nabaztag2018/hardware/nfc_V1.0/Position of P1.jpg

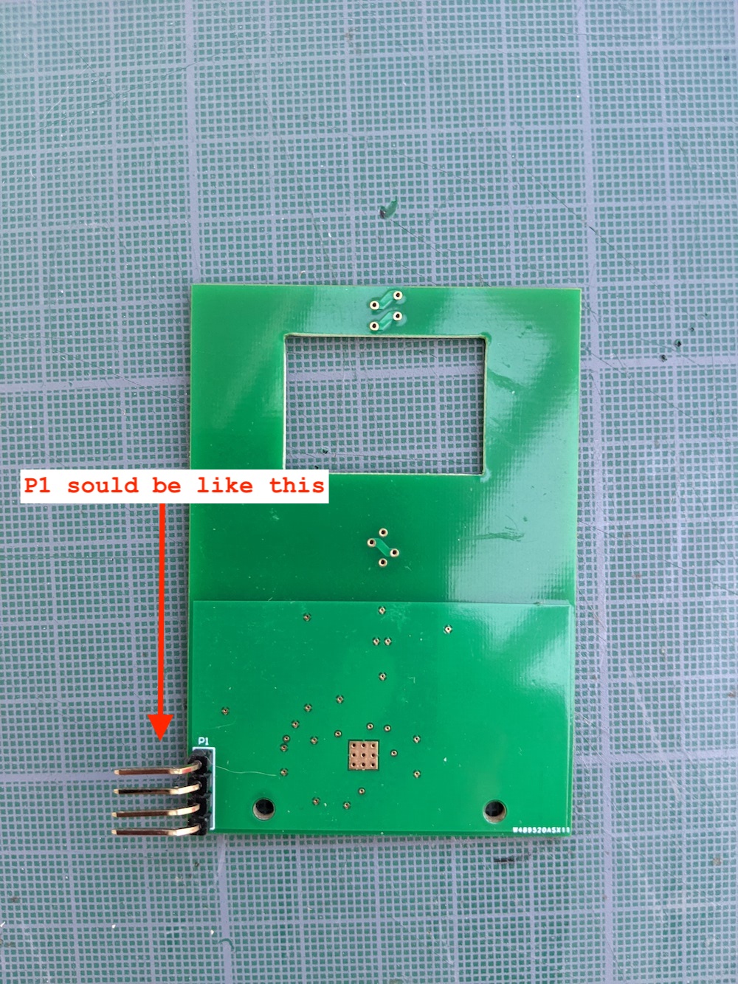
nfc_V1.0/Position of P1.jpg
