nabaztag2018/hardware/README.md

# Hardware

Tout ce qu'il faut pour refaire, modifier et surtout améliorer les cartes TagTagTag et NFC
