nabaztag2018/hardware/tagtagtag_V2.0/Nabaztag_RPI_V2.0_BOM.xlsx

Comment | Value | Quantity | Description | Designator | Unit price (octopart) | Package / Boitier | Voltage | Supplier link (octopart) | Supplier Link
CAPACITOR
0.1uF | 0.1uF | 26 | Non-polarised capacitor | C1, C2, C3, C4, C6, C8, C12, C15, C16, C17, C18, C20, C25, C27, C29, C31, C35, C36, C42, C46, C48, C49, C50, C52, C54, C62 | 0.088 | 0603 (1608 métrique) | 25V | 710-885012206071 (https://octopart.com/click/track?country=FR&ct=offers&ppid=53914780&sid=2401&sig=05a9095&vpid=254313904) | https://www.mouser.fr/ProductDetail/Wurth-Electronics/885012206071
10uF | 10uF | 13 | Non-polarised capacitor | C5, C10, C14, C24, C26, C30, C32, C37, C41, C45, C47, C51, C53 | 0.167 | 0603 (1608 métrique) | 10V | 81-GRM188R61A106KE9J (https://octopart.com/click/track?country=FR&ct=offers&ppid=57367330&sid=2401&sig=0bbd334&vpid=260629774) | https://eu.mouser.com/ProductDetail/Murata-Electronics/GRM188R61A106KE69J
1uF | 1uF | 6 | Non-polarised capacitor | C7, C11, C21, C28, C59, C61 | 0.14 | 0603 (1608 métrique) | 6,3V | 732-7900-1-ND (https://octopart.com/click/track?country=FR&ct=offers&ppid=53914708&sid=459&sig=0998f88&vpid=229678700) | https://www.digikey.fr/product-detail/fr/885012106003/732-7900-1-ND/5454527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
100uF | 100uF | 1 | polarised cap | C9 | 0.573 | Radial, boîtier métallique - CMS | 16V | PCE3750CT-ND (https://www.digikey.fr/product-detail/fr/panasonic-electronic-components/EEE-HC1C101XP/PCE3750CT-ND/672804) | https://www.digikey.fr/product-detail/fr/panasonic-electronic-components/EEE-HC1C101XP/PCE3750CT-ND/672804
1000uF | 1000uF | 1 | polarised cap | C13 | 0.27 | Radial, boîtier métallique - CMS | 6,3V | 2611416 (https://fr.farnell.com/multicomp/mcvvt6r3m102fb3l/condensateur-1000-f-6-3v-cms/dp/2611416?st=MCVVT6R3M102) | https://fr.farnell.com/multicomp/mcvvt6r3m102fb3l/condensateur-1000-f-6-3v-cms/dp/2611416?st=MCVVT6R3M102
220uF | 220uF | 1 | polarised cap | C19 | 0.439 | Radial, boîtier métallique - CMS | 16V | 1823839 (https://fr.farnell.com/nichicon/uwt1c221mcl1gs/aluminum-electrolytic-capacitor/dp/1823839?st=UWT1C221MCL1GS) | https://fr.farnell.com/nichicon/uwt1c221mcl1gs/aluminum-electrolytic-capacitor/dp/1823839?st=UWT1C221MCL1GS
100pF | 100pF | 2 | Non-polarised capacitor | C22, C60 | 0.11 | 0603 (1608 métrique) | 50V | 1710167 (https://fr.farnell.com/multicomp/mc0603n101k500ct/ceramic-capacitor-100pf-50v-c0g/dp/1710167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) | https://fr.farnell.com/multicomp/mc0603n101k500ct/ceramic-capacitor-100pf-50v-c0g/dp/1710167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
1nF | 1nF | 1 | Non-polarised capacitor | C23 | 0.1 | 0603 (1608 métrique) | 16V | 2904797 (https://fr.farnell.com/kemet/c0603s102k4racauto/cond-mlcc-aec-q200-1000pf-16v/dp/2904797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) | https://fr.farnell.com/kemet/c0603s102k4racauto/cond-mlcc-aec-q200-1000pf-16v/dp/2904797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
33pF | 33pF | 4 | Non-polarised capacitor | C43, C44, C55, C56 | 0.15 | 0603 (1608 métrique) | 50V | 1710223 (https://fr.farnell.com/multicomp/mc0603n330k500ct/ceramic-capacitor-33pf-50v-c0g/dp/1710223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) | https://fr.farnell.com/multicomp/mc0603n330k500ct/ceramic-capacitor-33pf-50v-c0g/dp/1710223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
4.7uF | 4.7uF | 2 | Non-polarised capacitor | C57, C58 | 0.09 | 0603 (1608 métrique) | 6,3V | 1276-1907-1-ND (https://www.digikey.fr/product-detail/fr/samsung-electro-mechanics/CL10A475MQ8NNNC/1276-1907-1-ND/3889993) | https://www.digikey.fr/product-detail/fr/samsung-electro-mechanics/CL10A475MQ8NNNC/1276-1907-1-ND/3889993
22uF | 22uF | 2 | Non-polarised capacitor | C38, C39 | 0.441 | 0603 (1608 métrique) | 6,3V | 810-C1608X5R0J226M (https://octopart.com/click/track?country=FR&ct=offers&ppid=26013464&sid=2401&sig=05a7d84&vpid=66164155) | https://www.mouser.fr/ProductDetail/TDK/C1608X5R0J226M080AC
470nF | 470nF | 2 | Non-polarised capacitor | C63, C64 | 0.2 | 0603 (1608 métrique) | 16V | 490-3295-1-ND (https://octopart.com/click/track?country=FR&ct=offers&ppid=196914&sid=459&sig=000aa69&vpid=1208009) | https://www.digikey.fr/product-detail/fr/GRM188R71C474KA88D/490-3295-1-ND/702836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
75pF | 75pF | 1 | Non-polarised capacitor | C40 | 0.273 | 0603 (1608 métrique) | 50v | 80-C0603C750J5G (https://octopart.com/click/track?country=FR&ct=offers&ppid=9138607&sid=2401&sig=06368cf&vpid=37752048) | https://www.mouser.fr/ProductDetail/KEMET/C0603C750J5GACTU
DIODES
Diode 1N4001 |  | 1 | Diode | D1 | 0.1 | DO-204AL, DO-41, axial |  | 641-1310-1-ND (https://octopart.com/click/track?country=FR&ct=offers&ppid=19043185&sid=459&sig=0e15afc&vpid=34052689) | https://www.digikey.fr/product-detail/fr/1N4001-G/641-1310-1-ND/1979675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
Diode_Transil_SM6T |  | 1 | Diode | D2 | 0.405 | DO-214AA-2 (SMB) |  | 511-SM6T12CA (https://octopart.com/click/track?country=FR&ct=offers&ppid=349709&sid=2401&sig=0472e83&vpid=40871267) | https://www.mouser.fr/ProductDetail/STMicroelectronics/SM6T12CA
Diode_Shottky_VS-20BQ030HM3 |  | 1 | Diode | D3 | 0.44 | DO-214AA, SMB |  | VS-20BQ030HM3/5BTGI-ND (https://octopart.com/click/track?country=FR&ct=offers&ppid=65895459&sid=459&sig=0223a70&vpid=448911440) | https://www.digikey.fr/product-detail/fr/VS-20BQ030HM3-5BT/VS-20BQ030HM3-5BTGI-ND/5134969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
Diode Toshiba DF2S6.8FS,L3M |  | 1 | Diode | D4 | 0.16 | SOD-923 |  | DF2S6.8FS(TL4D)CT-ND (https://www.digikey.fr/product-detail/fr/toshiba-semiconductor-and-storage/DF2S6.8FSL3M/DF2S6.8FS-TL4D-CT-ND/3191336) | https://www.digikey.fr/product-detail/fr/toshiba-semiconductor-and-storage/DF2S6.8FSL3M/DF2S6.8FS-TL4D-CT-ND/3191336
INDUCTOR
33ohm | 33ohm | 2 | Inductor 0603 BLM18PG330SN | L1, L2 | 0.09 | 0603 (1608 métrique) |  | 490-5220-1-ND (https://octopart.com/click/track?country=FR&ct=offers&ppid=755255&sid=459&sig=0d2c2fc&vpid=34232814) | https://www.digikey.fr/product-detail/fr/BLM18PG330SN1D/490-5220-1-ND/1948396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
Murata_1264EY-150M=P3 | 15uH | 1 | Inductor 15uH | L3 | 0.56 | 2424 (6060) |  | 2871570RL (https://fr.farnell.com/murata/1264ey-150m-p3/inductance-15uh-2-1a-20-bobinee/dp/2871570RL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) | https://fr.farnell.com/murata/1264ey-150m-p3/inductance-15uh-2-1a-20-bobinee/dp/2871570RL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
100ohm | 100ohm | 1 | Inductor MPZ1608D101BTA00 | L4 | 0.09 | 0603 (1608 métrique) |  | 445-2988-1-ND (https://www.digikey.fr/product-detail/fr/tdk-corporation/MPZ1608D101BTA00/445-2988-1-ND/1084531) | https://www.digikey.fr/product-detail/fr/tdk-corporation/MPZ1608D101BTA00/445-2988-1-ND/1084531
2.5kohm | 2.5kohm | 2 | Inductor BLM18BD252SN1D | L5, L6 | 0.723 | 0603 (1608 métrique) |  | 490-1028-1-ND (https://www.digikey.fr/product-detail/fr/murata-electronics-north-america/BLM18BD252SN1D/490-1028-1-ND/584476) | https://www.digikey.fr/product-detail/fr/murata-electronics-north-america/BLM18BD252SN1D/490-1028-1-ND/584476
100nH | 100nH | 2 | Inductor MLZ1608DR10DT | L7, L8 | 0.138 | 0603 (1608 métrique) |  | 2215630 (https://fr.farnell.com/tdk/mlz1608dr10dt/inductance-0-1uh-5-blindee/dp/2215630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) | https://fr.farnell.com/tdk/mlz1608dr10dt/inductance-0-1uh-5-blindee/dp/2215630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
RESISTOR
470ohm | 470 ohm | 2 | Resistor | R1, R3 | 0.088 | 0603 (1608 métrique) |  | 2908375 (https://fr.farnell.com/bourns/cr0603-jw-471elf/resis-couche-epaisse-470r-0-1w/dp/2908375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) | https://fr.farnell.com/bourns/cr0603-jw-471elf/resis-couche-epaisse-470r-0-1w/dp/2908375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
10kohm | 10 kohm | 11 | Resistor | R2, R4, R5, R6, R8, R9, R13, R14, R15, R19, R37 | 0.09 | 0603 (1608 métrique) |  | 1632392 (https://fr.farnell.com/multicomp/mc0603saf1002t5e/res-thick-film-10k-1-0-1w-0603/dp/1632392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) | https://fr.farnell.com/multicomp/mc0603saf1002t5e/res-thick-film-10k-1-0-1w-0603/dp/1632392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
20kohm | 20 kohm | 1 | Resistor | R7 | 0.088 | 0603 (1608 métrique) |  | RHM20KDCT-ND (https://octopart.com/click/track?country=FR&ct=offers&ppid=29236154&sid=459&sig=0eb9ce1&vpid=76920462) | https://www.digikey.fr/product-detail/fr/ESR03EZPJ203/RHM20KDCT-ND/4053745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
120ohm | 120 ohm | 2 | Resistor | R11, R12 | 0.09 | 0603 (1608 métrique) |  | 1652832 (https://fr.farnell.com/vishay/crcw0603120rfkea/res-couche-epaisse-120r-1-0-1w/dp/1652832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) | https://fr.farnell.com/vishay/crcw0603120rfkea/res-couche-epaisse-120r-1-0-1w/dp/1652832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
1kohm | 1 kohm | 3 | Resistor | R18, R34, R35 | 0.14 | 0603 (1608 métrique) |  | 2335830 (https://fr.farnell.com/panasonic/erjpa3f1001v/res-couche-epaisse-1k-1-0-25w/dp/2335830?CMP=GRHB-OCTOPART) | https://fr.farnell.com/panasonic/erjpa3f1001v/res-couche-epaisse-1k-1-0-25w/dp/2335830?CMP=GRHB-OCTOPART
10ohm | 10 ohm | 5 | Resistor | R20, R21, R22, R31, R32 | 0.09 | 0603 (1608 métrique) |  | P10.00BYCT-ND (https://octopart.com/click/track?country=FR&ct=offers&ppid=51302195&sid=459&sig=0e775f9&vpid=175672005) | https://www.digikey.fr/product-detail/fr/ERJ-PA3F10R0V/P10.00BYCT-ND/5036118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
4.7kohm | 4.7 kohm | 4 | Resistor | R10, R16, R23, R24 | 0.09 | 0603 (1608 métrique) |  | P4.7KGCT-ND (https://octopart.com/click/track?country=FR&ct=offers&ppid=55422110&sid=459&sig=073857f&vpid=188062302) | https://www.digikey.fr/product-detail/fr/ERJ-3GEYJ472V/P4.7KGCT-ND/135199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
510kohm | 510 kohm | 1 | Resistor | R27 | 0.09 | 0603 (1608 métrique) |  | P510KHCT-ND (https://octopart.com/click/track?country=FR&ct=offers&ppid=55403664&sid=459&sig=0ed8e5a&vpid=188061721) | https://www.digikey.fr/product-detail/fr/ERJ-3EKF5103V/P510KHCT-ND/1746789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
49.9ohm | 49.9 ohm | 1 | Resistor | R28 | 0.09 | 0603 (1608 métrique) |  | P49.9HCT-ND (https://octopart.com/click/track?country=FR&ct=offers&ppid=55421799&sid=459&sig=04574ae&vpid=188061714) | https://www.digikey.fr/product-detail/fr/ERJ-3EKF49R9V/P49.9HCT-ND/198412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
100kohm | 100 kohm | 2 | Resistor | R17, R29 | 0.09 | 0603 (1608 métrique) |  | 1646028 (https://fr.farnell.com/multicomp/mc0603saf1003t5e/res-thick-film-100k-1-0-1w-0603/dp/1646028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) | https://fr.farnell.com/multicomp/mc0603saf1003t5e/res-thick-film-100k-1-0-1w-0603/dp/1646028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
13.3kohm | 13.3 kohm | 1 | Resistor | R30 | 0.09 | 0603 (1608 métrique) |  | P13.3KHCT-ND (https://octopart.com/click/track?country=FR&ct=offers&ppid=55421458&sid=459&sig=0123c35&vpid=188060510) | https://www.digikey.fr/product-detail/fr/ERJ-3EKF1332V/P13.3KHCT-ND/198150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
15kohm | 15 kohm | 1 | Resistor | R38 | 0.09 | 0603 (1608 métrique) |  | P15KGCT-ND (https://octopart.com/click/track?country=FR&ct=offers&ppid=55397035&sid=459&sig=0191300&vpid=188062134) | https://www.digikey.fr/product-detail/fr/ERJ-3GEYJ153V/P15KGCT-ND/62708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
30.1kohm | 30.1 kohm | 2 | Resistor | R25, R26 | 0.09 | 0603 (1608 métrique) |  | P30.1KHCT-ND (https://octopart.com/click/track?country=FR&ct=offers&ppid=55421673&sid=459&sig=05b57b3&vpid=188061214) | https://www.digikey.fr/product-detail/fr/ERJ-3EKF3012V/P30.1KHCT-ND/198319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
100ohm | 100 ohm | 2 | Resistor | R33, R36 | 0.09 | 0603 (1608 métrique) |  | P100GCT-ND (https://www.digikey.fr/product-detail/fr/panasonic-electronic-components/ERJ-3GEYJ101V/P100GCT-ND/134714) | https://www.digikey.fr/product-detail/fr/panasonic-electronic-components/ERJ-3GEYJ101V/P100GCT-ND/134714
LEDs
Neopixel_3535 |  | 5 |  | U1, U2, U3, U4, U10 | 0.429 | SK6812 (3535) |  | 1528-1542-ND (https://octopart.com/click/track?country=FR&ct=offers&ppid=68087194&sid=459&sig=01d4183&vpid=244416654) | https://www.digikey.fr/product-detail/fr/2659/1528-1542-ND/5804108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
ICs
CMM-3729AT-42316-TR |  | 2 | Mems microphone | MIC1, MIC2 | 1.28 | 3.76 MM X 2.24 MM |  | 102-5078-1-ND (https://www.digikey.fr/product-detail/fr/CMM-3729AT-42316-TR/102-5078-1-ND/9748846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) | https://www.digikey.fr/product-detail/fr/CMM-3729AT-42316-TR/102-5078-1-ND/9748846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
SN754410NE |  | 1 | Quadruple Half-H Driver | U5 | 2.1 | DIP 16 |  | 1470411 (https://octopart.com/click/track?country=FR&ct=offers&ppid=1320&sid=819&sig=0953c5b&vpid=548228289) | https://fr.farnell.com/texas-instruments/sn754410ne/ic-peripheral-driver-half-h-1a/dp/1470411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
LM1117MPX-3.3/NOPB |  | 1 | 800mA Low-Dropout Linear Regulator, 4-pin SOT-223, Pb-Free | U6 | 0.969 | SOT-223-4 |  | 926-LM1117MPX3.3NOPB (https://octopart.com/click/track?country=FR&ct=offers&ppid=22615741&sid=2401&sig=030e488&vpid=57203299) | https://www.mouser.fr/ProductDetail/Texas-Instruments/LM1117MPX-33-NOPB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
LM393D |  | 1 | Dual Differential Comparator | U7 | 0.36 | 8-SOIC |  | 296-1015-5-ND (https://octopart.com/click/track?country=FR&ct=offers&ppid=55400836&sid=459&sig=0240896&vpid=188084280) | https://www.digikey.fr/product-detail/fr/LM393D/296-1015-5-ND/277044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
SN74LVC2G17DBVR |  | 1 | Dual schmitt trigger buffer | U8 | 0.467 | SOT-23-6 |  | 595-SN74LVC2G17DBVR (https://octopart.com/click/track?country=FR&ct=offers&ppid=422947&sid=2401&sig=0809b4c&vpid=37654799) | https://www.mouser.fr/ProductDetail/595-SN74LVC2G17DBVR
BSS138 |  | 2 | N channel MOSFET | U9, U11 | 0.38 | SOT-23-3 |  | BSS138NH6327XTSA2CT-ND (https://octopart.com/click/track?country=FR&ct=offers&ppid=21522140&sid=459&sig=0c629b9&vpid=220828518) | https://www.digikey.fr/product-detail/fr/BSS138NH6327XTSA2/BSS138NH6327XTSA2CT-ND/5413728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
Si7021-A20 |  | 1 | Si7021-A20 | U12 | 2.5 | 6-WDFN plot exposé |  | 336-3140-5-ND (https://www.digikey.fr/product-detail/fr/silicon-labs/SI7021-A20-GM/336-3140-5-ND/5048933) | https://www.digikey.fr/product-detail/fr/silicon-labs/SI7021-A20-GM/336-3140-5-ND/5048933
TPS54202H |  | 1 | Power regulator 5V reg | U14 | 1.64 | SOT 6 broches |  | 2576277 (https://octopart.com/click/track?country=FR&ct=offers&ppid=71538131&sid=819&sig=0abfb4f&vpid=548229904) | https://fr.farnell.com/texas-instruments/tps54202hddct/convert-dc-dc-sync-buck-500khz/dp/2576277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
LIS3DHTR |  | 1 | Accélérometer | U15 | 1.36 | 16-VFLGA |  | 497-10613-1-ND (https://www.digikey.fr/product-detail/fr/stmicroelectronics/LIS3DHTR/497-10613-1-ND/2334355) | https://www.digikey.fr/product-detail/fr/stmicroelectronics/LIS3DHTR/497-10613-1-ND/2334355
MAX9759ETE+T |  | 1 | Ampli audio | U13 | 1.86 | TQFN-EP-16 |  | 700-MAX9759ETE+T | https://www.mouser.fr/ProductDetail/Maxim-Integrated/MAX9759ETE%2bT
WM8960 codec |  | 1 | CODEC audio | U16 | 4.51 | QFN-32 |  | 238-WM8960CGEFL/V (https://eu.mouser.com/ProductDetail/Cirrus-Logic/WM8960CGEFL-V) | https://eu.mouser.com/ProductDetail/Cirrus-Logic/WM8960CGEFL-V
12MHz XTAL 2520 |  | 1 | 12MHz | X1 | 1.33 | 4-SMD, sans plomb |  | XC2194CT-ND (https://octopart.com/click/track?country=FR&ct=offers&ppid=77034890&sid=459&sig=0da475c&vpid=362740770) | https://www.digikey.fr/product-detail/fr/ECS-2520S33-120-FN-TR/XC2194CT-ND/6578501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
HEADER
Header 8x1 |  | 2 | V1 Motor/ears Headers - MONTAGE FACE TOP | H1, H2 | 0,076 (x50) |  |  | 1593431 (https://octopart.com/click/track?country=FR&ct=offers&ppid=11931880&sid=819&sig=0c77011&vpid=140706856) | https://fr.farnell.com/multicomp/mc34753/embase-male-1-rangee-coude-8voies/dp/1593431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
Header 2x1 |  | 3 | Push button / Speaker 8ohm / Speaker 4 ohm (H13 - MONTAGE FACE BOTTOM) | H3, H7, H13 | 0,0184 (x50) |  |  | 1593426 (https://fr.farnell.com/multicomp/mc34745/embase-male-1-rangee-coude-2voies/dp/1593426) | https://fr.farnell.com/multicomp/mc34745/embase-male-1-rangee-coude-2voies/dp/1593426
Header 4x1 |  | 2 | I2C Header RFID (5V) / I2C Header 3V3 - MONTAGE FACE BOTTOM | H4, H11 | 0,0376 (x50) |  |  | 1593428 (https://octopart.com/click/track?country=FR&ct=offers&ppid=11931878&sid=819&sig=002c2ef&vpid=140706852) | https://fr.farnell.com/multicomp/mc34749/embase-male-1-rangee-coude-4voies/dp/1593428
Header 3x1 |  | 3 | Volume setting Header / Power Header / Line out | H5, H6, H12 | 0,0283 (x50) |  |  | 1593427 (https://octopart.com/click/track?country=FR&ct=offers&ppid=11931877&sid=819&sig=0b5d426&vpid=140706850) | https://fr.farnell.com/multicomp/mc34747/embase-male-1-rangee-coude-3voies/dp/1593427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
RPI_B+_Header |  | 1 | RPI_B+_Header | H8 | 0.98 |  |  | 2847248 (https://fr.farnell.com/multicomp/2214s-40sg-85/connecteur-femelle-40-voies-2/dp/2847248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) | https://fr.farnell.com/multicomp/2214s-40sg-85/connecteur-femelle-40-voies-2/dp/2847248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
Header 6x1 |  | 2 | V2 Motor/ears Headers - MONTAGE FACE BOTTOM | H9, H10 | 0,0551 (x50) |  |  | 1593430 (https://octopart.com/click/track?country=FR&ct=offers&ppid=11931879&sid=819&sig=0c65bd2&vpid=140706854) | https://fr.farnell.com/molex/22-05-2061/conn-header-6-voies-1-rang-2-54mm/dp/9731229?scope=partnumberlookahead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
D.N.P |  | 2 | D.N.P | H14, H15 | 0
