nabaztag2018/hardware/nfc_V1.0/ExportSTEP/NABAZTAG_RFID_ST25R_v1.1.step

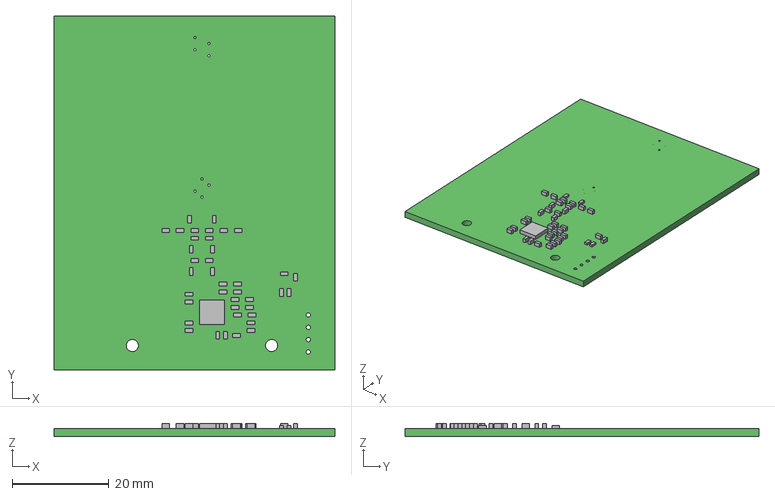
[picture p2: CAD file, 2022-07-05]
nfc_V1.0/ExportSTEP/NABAZTAG_RFID_ST25R_v1.1.step
58.0 x 73.2 x 2.70 mm
Extruded x 40
