nabaztag2018/hardware/(threads)

Thread 1 (2019-08-16):

Open source ?

Salamandar, 2019-08-16:
Hello,

Your project was claimed as open source, but there is no source here, only Gerber and BOM.

Could you please push your Altium sources ? I'd love to convert them to a KiCAD project for more accessibility.

Salamandar, 2019-08-17:
Hi,
I kinda understood how it's organized (the version number on the pdf files), and I discovered that the Gerber files are from v2 version. Where are the gerber from the v4.1 version ?

Salamandar, 2019-08-17:
I also detected bugs on the v4.1 pdf. The pin 4 of the audio component should be connected according to the schematics, but it's not on the PCB pdf pages.

Salamandar, 2019-08-17:
Also, the audio component is not WS8960 (as written on the issue), but WM8960.

pguyot, 2019-09-01:
@Salamandar Thank you for your report. I believe pin 4 of WM8960 is connected in latest version of the schematics (4.3) which have yet to be uploaded on GH. This is a work in progress!

232enero, 2019-09-02:
@Salamandar / Regarding the open source question : yes we will push the Altium sources as soon as we believe we have a final PCB.

Salamandar, 2019-09-06:
@232enero Thanks. That will allow people who didn't get a kit to build their own.
Also, I started to rewrite the project on a more opensource-friendly CAD software, KiCAD. But without the latest design, I can't do much ;)

232enero, 2019-09-06:
@Salamandar We also offer, for free, PCB for those who can solder SMT components (no stencil though...).

Salamandar, 2019-09-10:
@232enero I'm not afraid of very small SMD, but without a soldering station you can't solder the mics.
You could have done a footprint with long pads accessible from around the component to allow handsoldering ;)

Thread 2 (2019-10-28):

NeoPixel LEDs generate noise in recordings

pguyot, 2019-10-28:
When the LEDs are on, there is a very strong noise sound in recordings at about 1.2kHz.

Thread 3 (2019-10-28):

Volume button signal is inverted between Tag and TagTag

pguyot, 2019-10-28:
Volume button GPIOs (22 & 27) do not have the same truth table on a V1 (Nabaztag) and a V2 (Nabaztagtag).

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

Thread 4 (2019-10-28):

RFID sensor does not work when too close to the Raspberry Pi

pguyot, 2019-10-28:
The Raspberry Pi generates interferences that prevent the RFID sensor to work properly.
Workaround consists in adding some cardboard.

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

Thread 6 (2019-10-28):

Jack plug does not cut speakers at the hardware level

pguyot, 2019-10-28:
WM8960 SoC provides a mechanism to cut speakers at the hardware level. However, the SoC is installed in such a way that the Jack plug does not cut speakers at the hardware level and a software daemon is required.

michnixweiss, 2021-01-23:
Hey @pguyot can you please post your solution. If have the same issue and only got it solved with soldering!?

pguyot, 2021-01-23:
The solution is separate tagtagtag-mixer software daemon that modifies levels when something is plugged into the jack port.
https://github.com/pguyot/wm8960/tree/tagtagtag-sound

Thread 7 (2019-10-28):

Ferret microphone does not work

pguyot, 2019-10-28:
TagTag come with a ferret microphone. It can supposedly be used instead of on-board microphones by soldering jumpers. Yet it does not work, maybe because the schema should use Micbias SoC output and actually doesn't.

Thread 8 (2019-10-28):

Temperature sensor Si7021 measure temperature inside the case

pguyot, 2019-10-28:
Temperature sensor fails to account for external temperature and is probably too close to the Raspberry Pi.
