nabaztag2018/hardware/nfc_V1.0/NABAZTAG_RFID_ST25R_v1.1.PDF

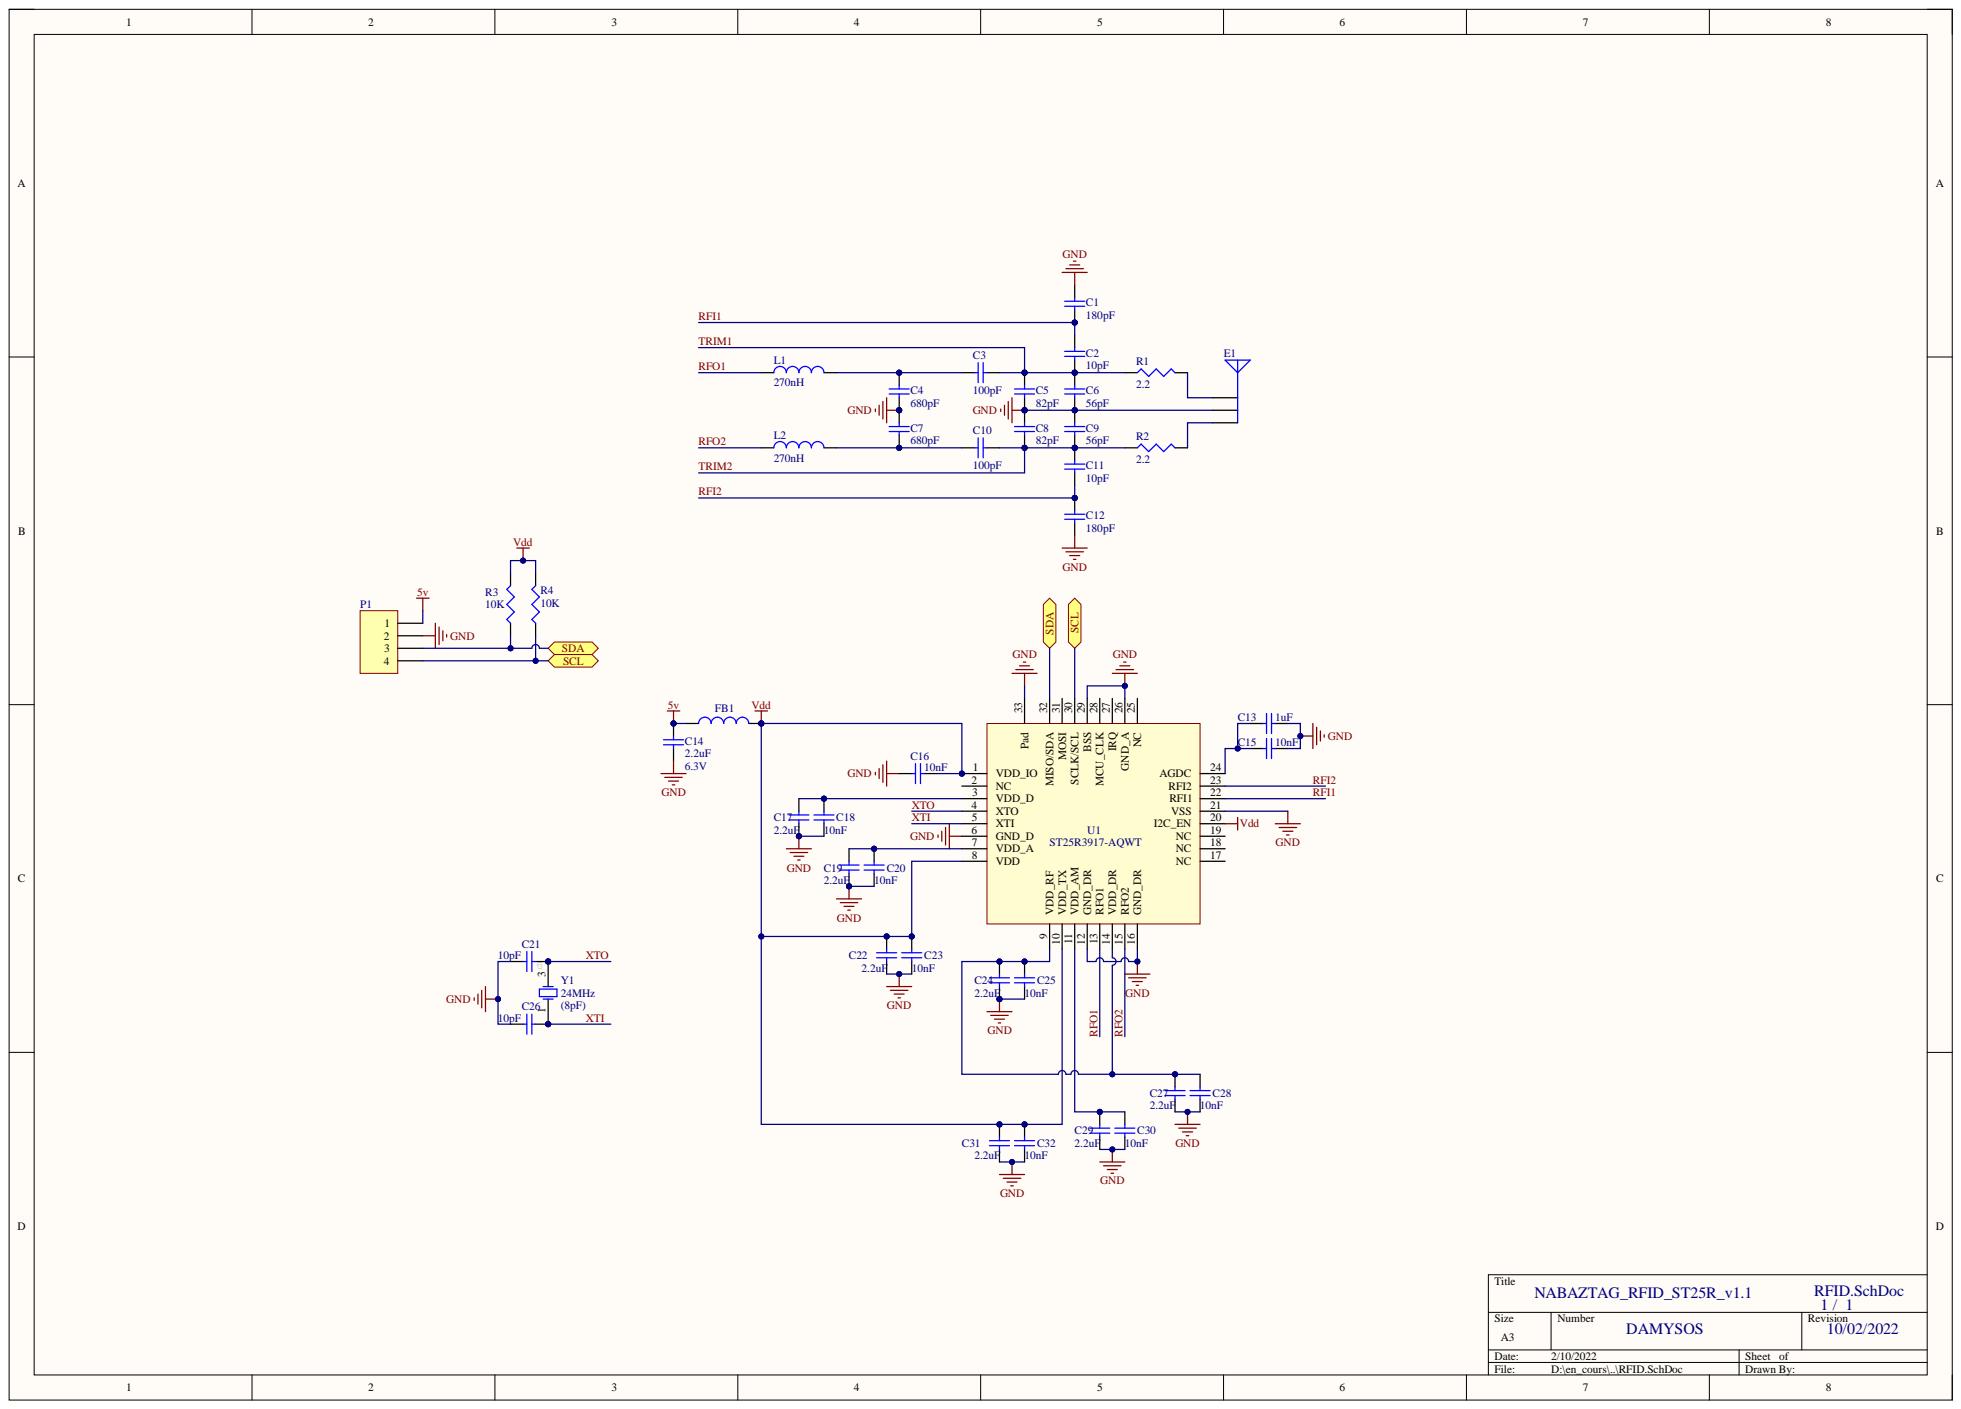
[picture p3: page 1]

XTO C18 | XTO 4

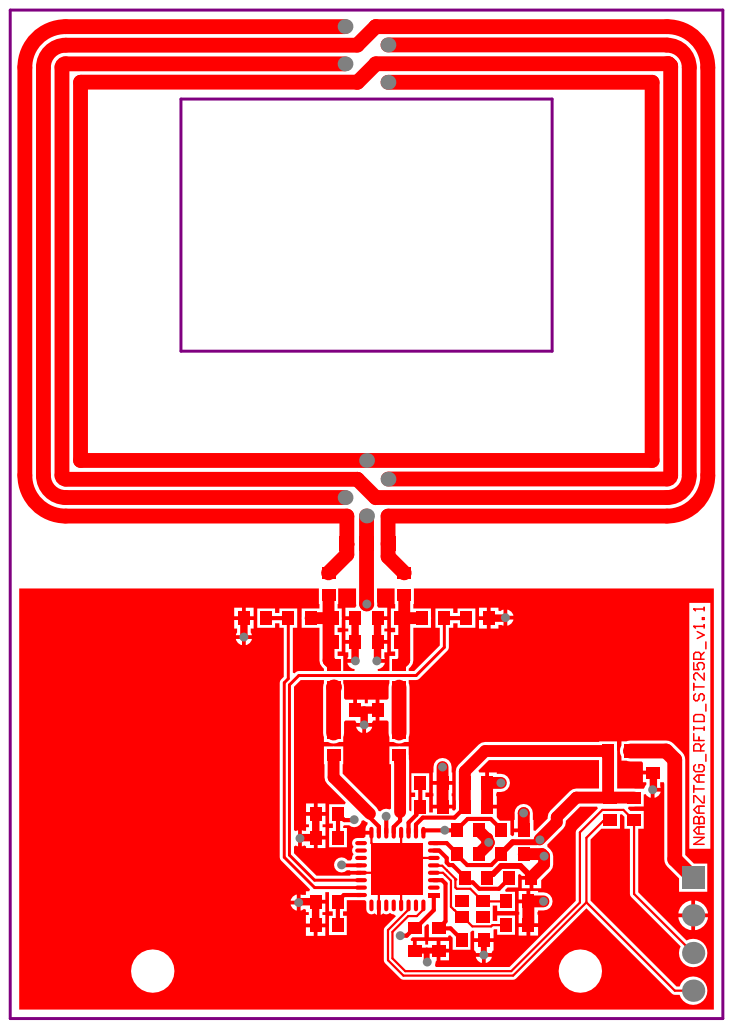
[picture p4: page 2]

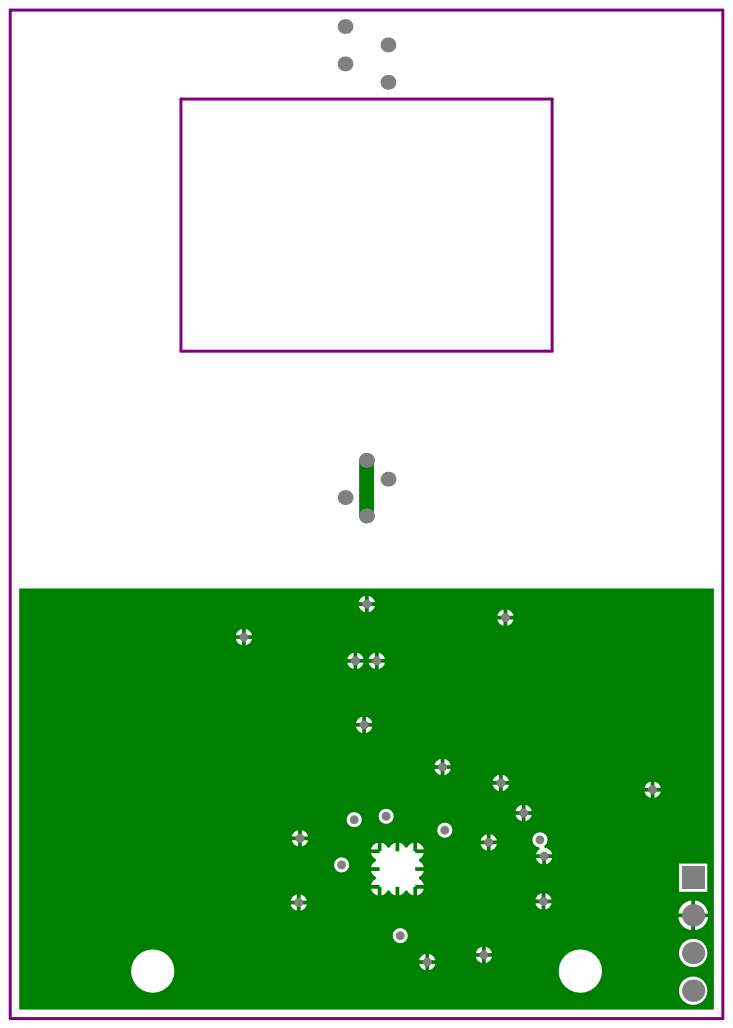
[picture p5: page 3]

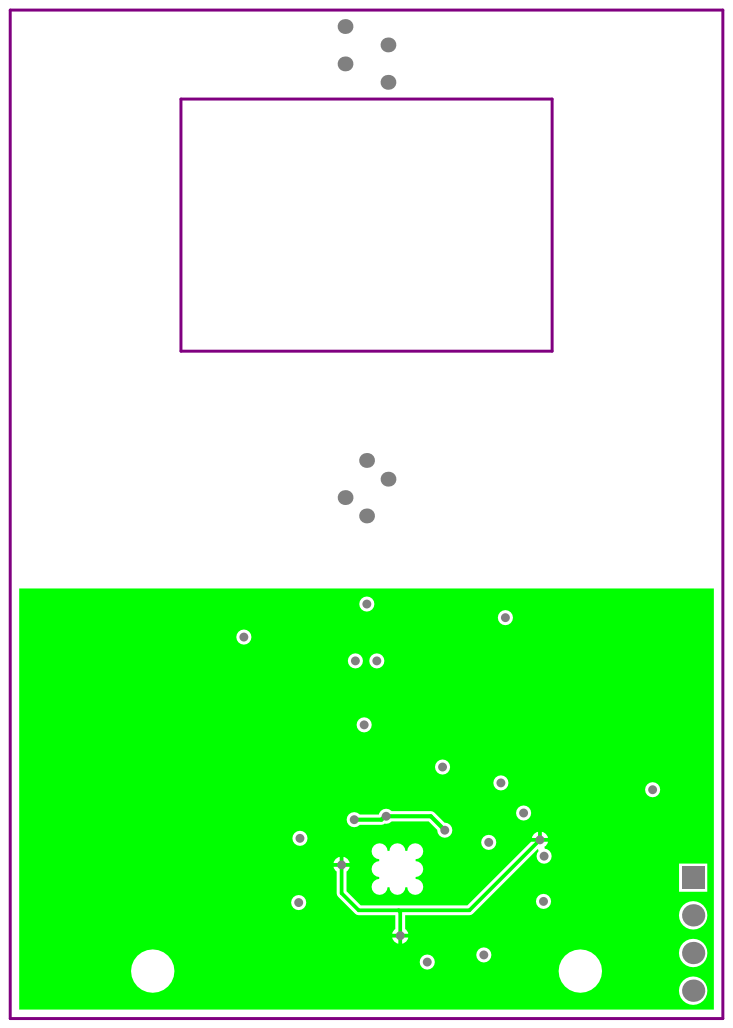
[picture p6: page 4]

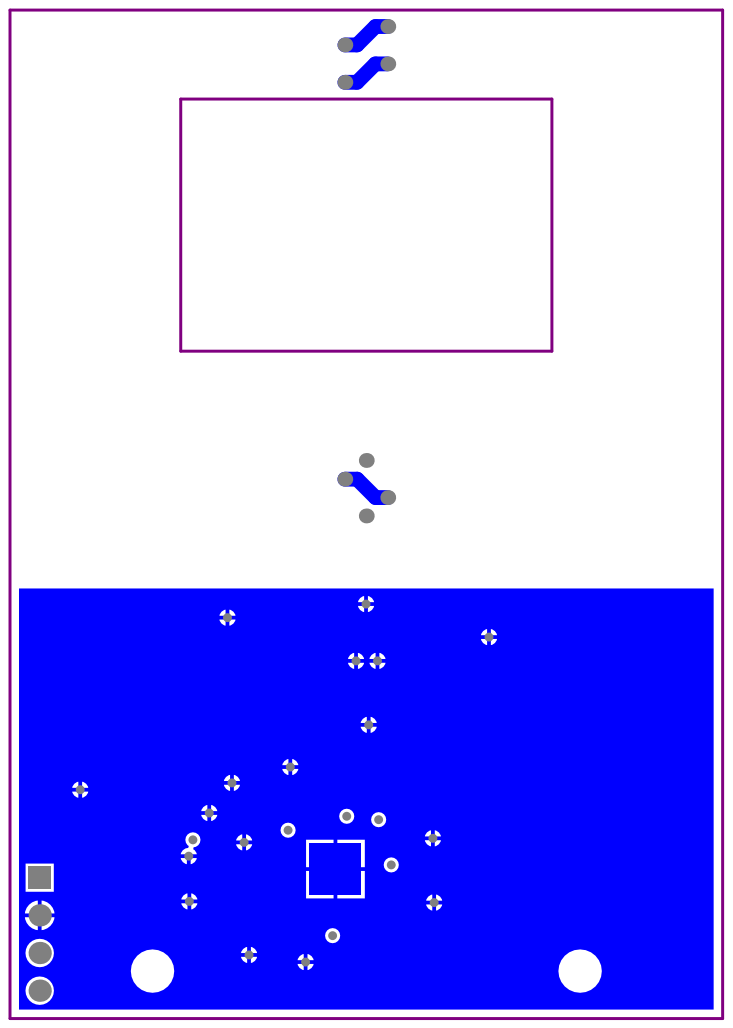
[picture p7: page 5]

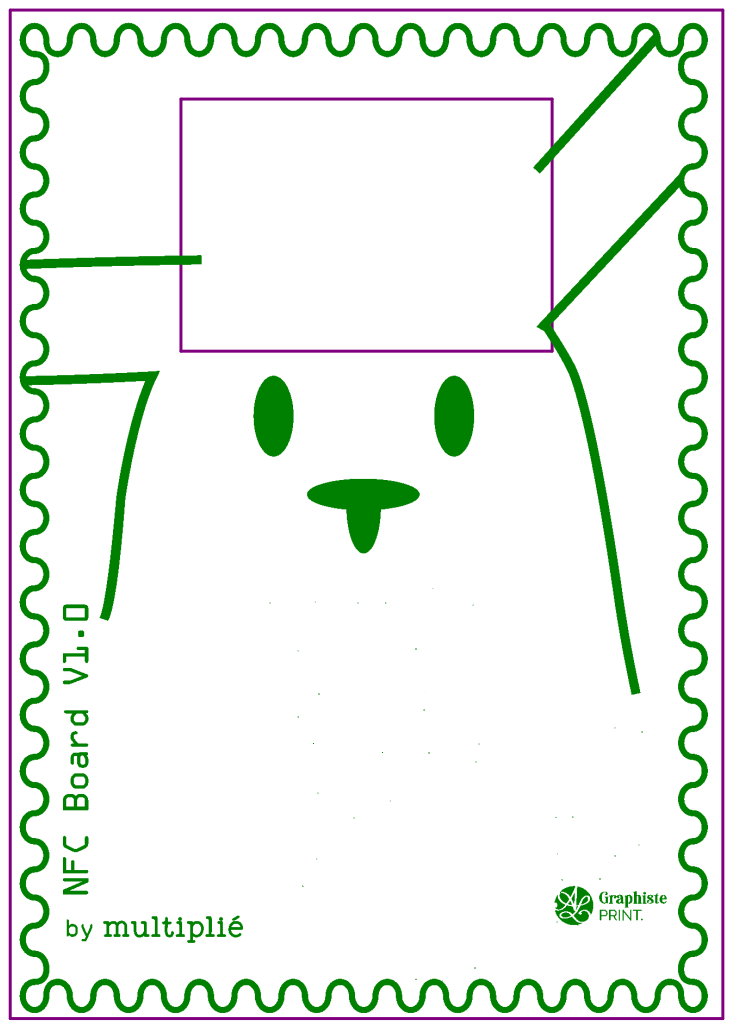
[picture p8: page 6]

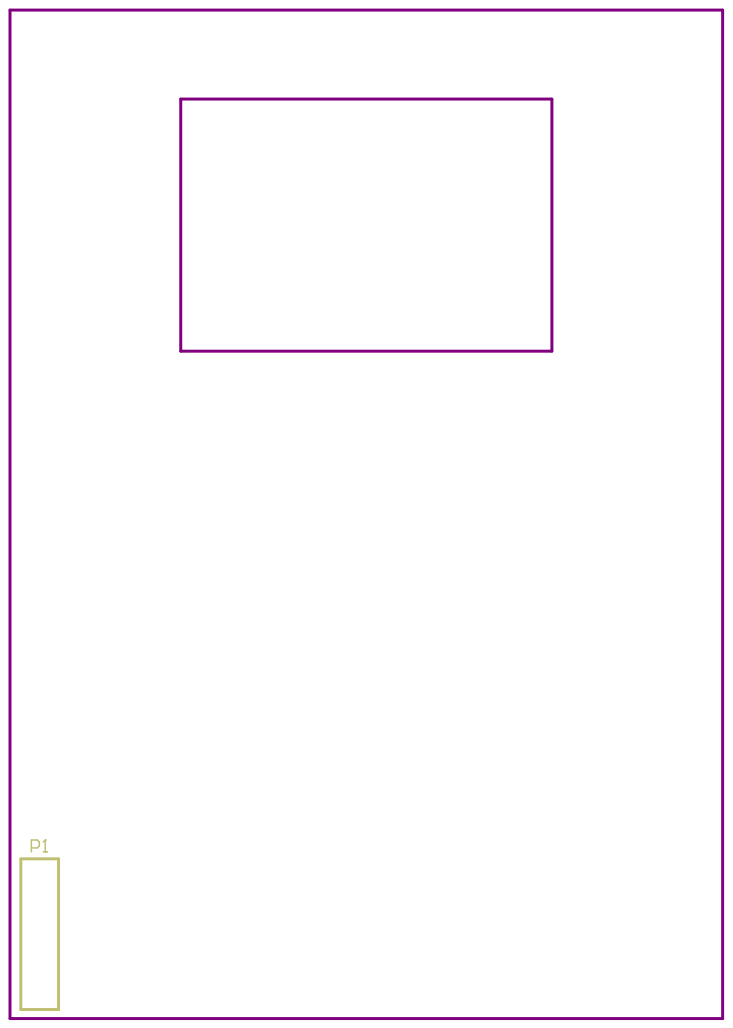
[picture p9: page 7]

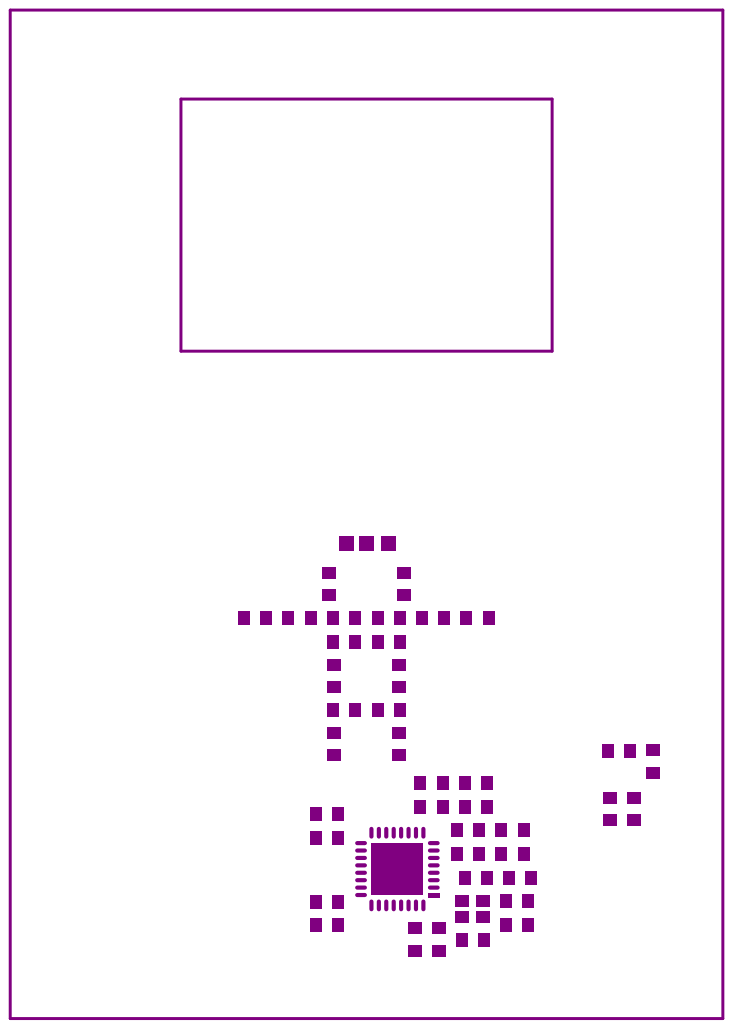
[picture p10: page 8]

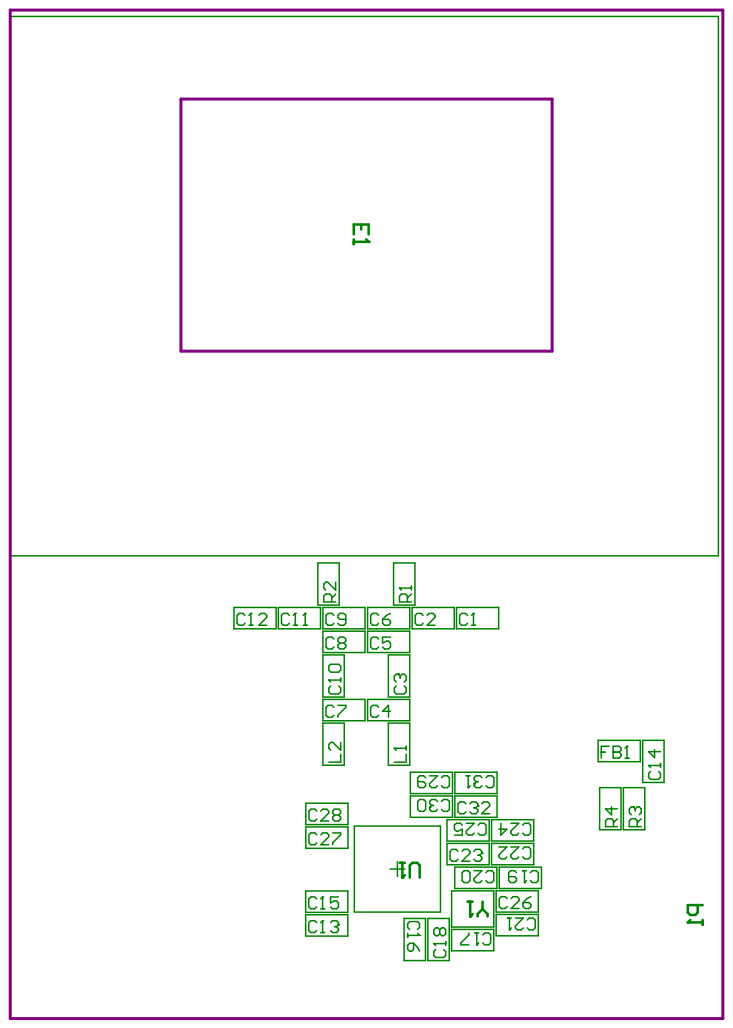
[picture p11: page 10]

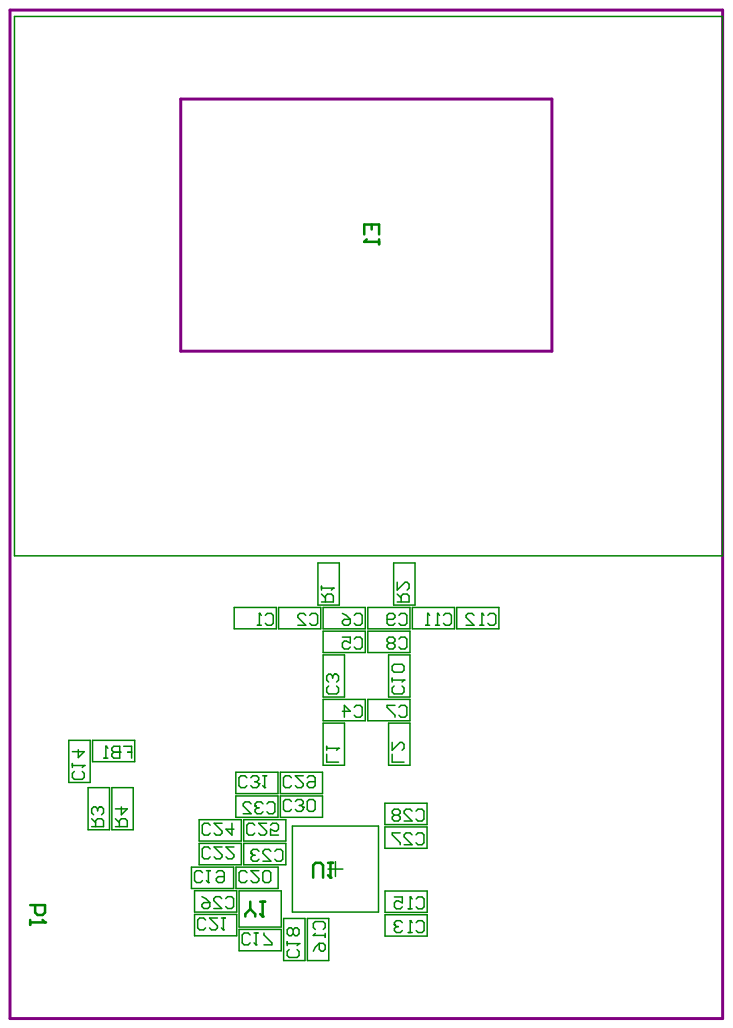
[picture p12: page 11]

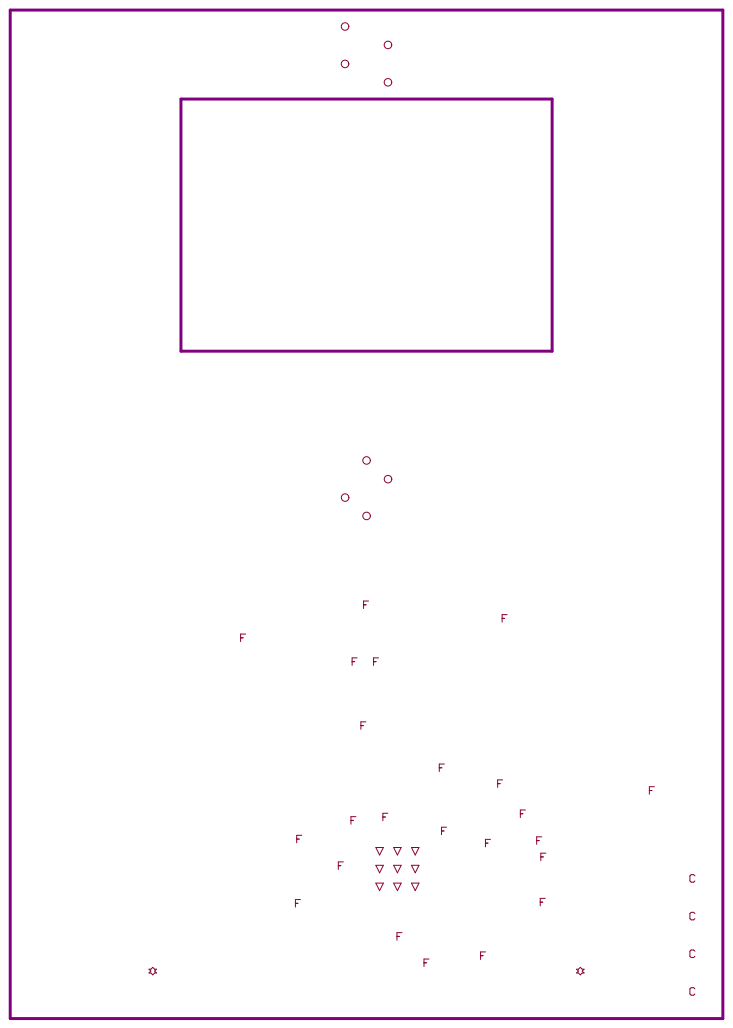
[picture p13: page 12]

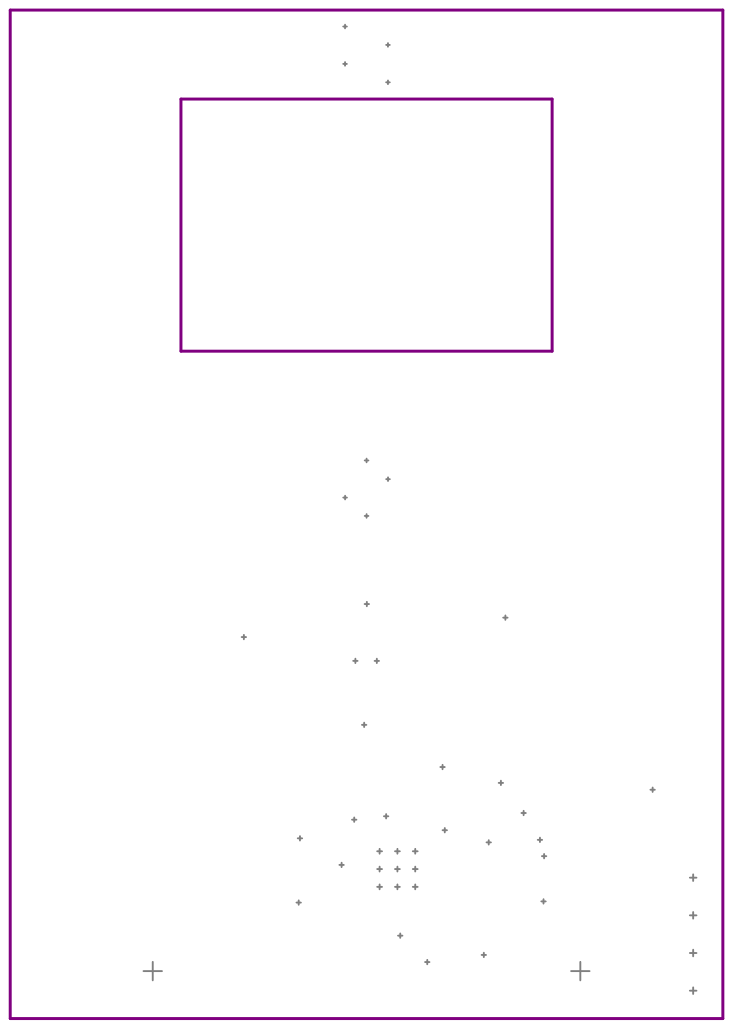
[picture p14: page 13]
