nabaztag2018/hardware/legacy/RPI_Nabaztag.PDF

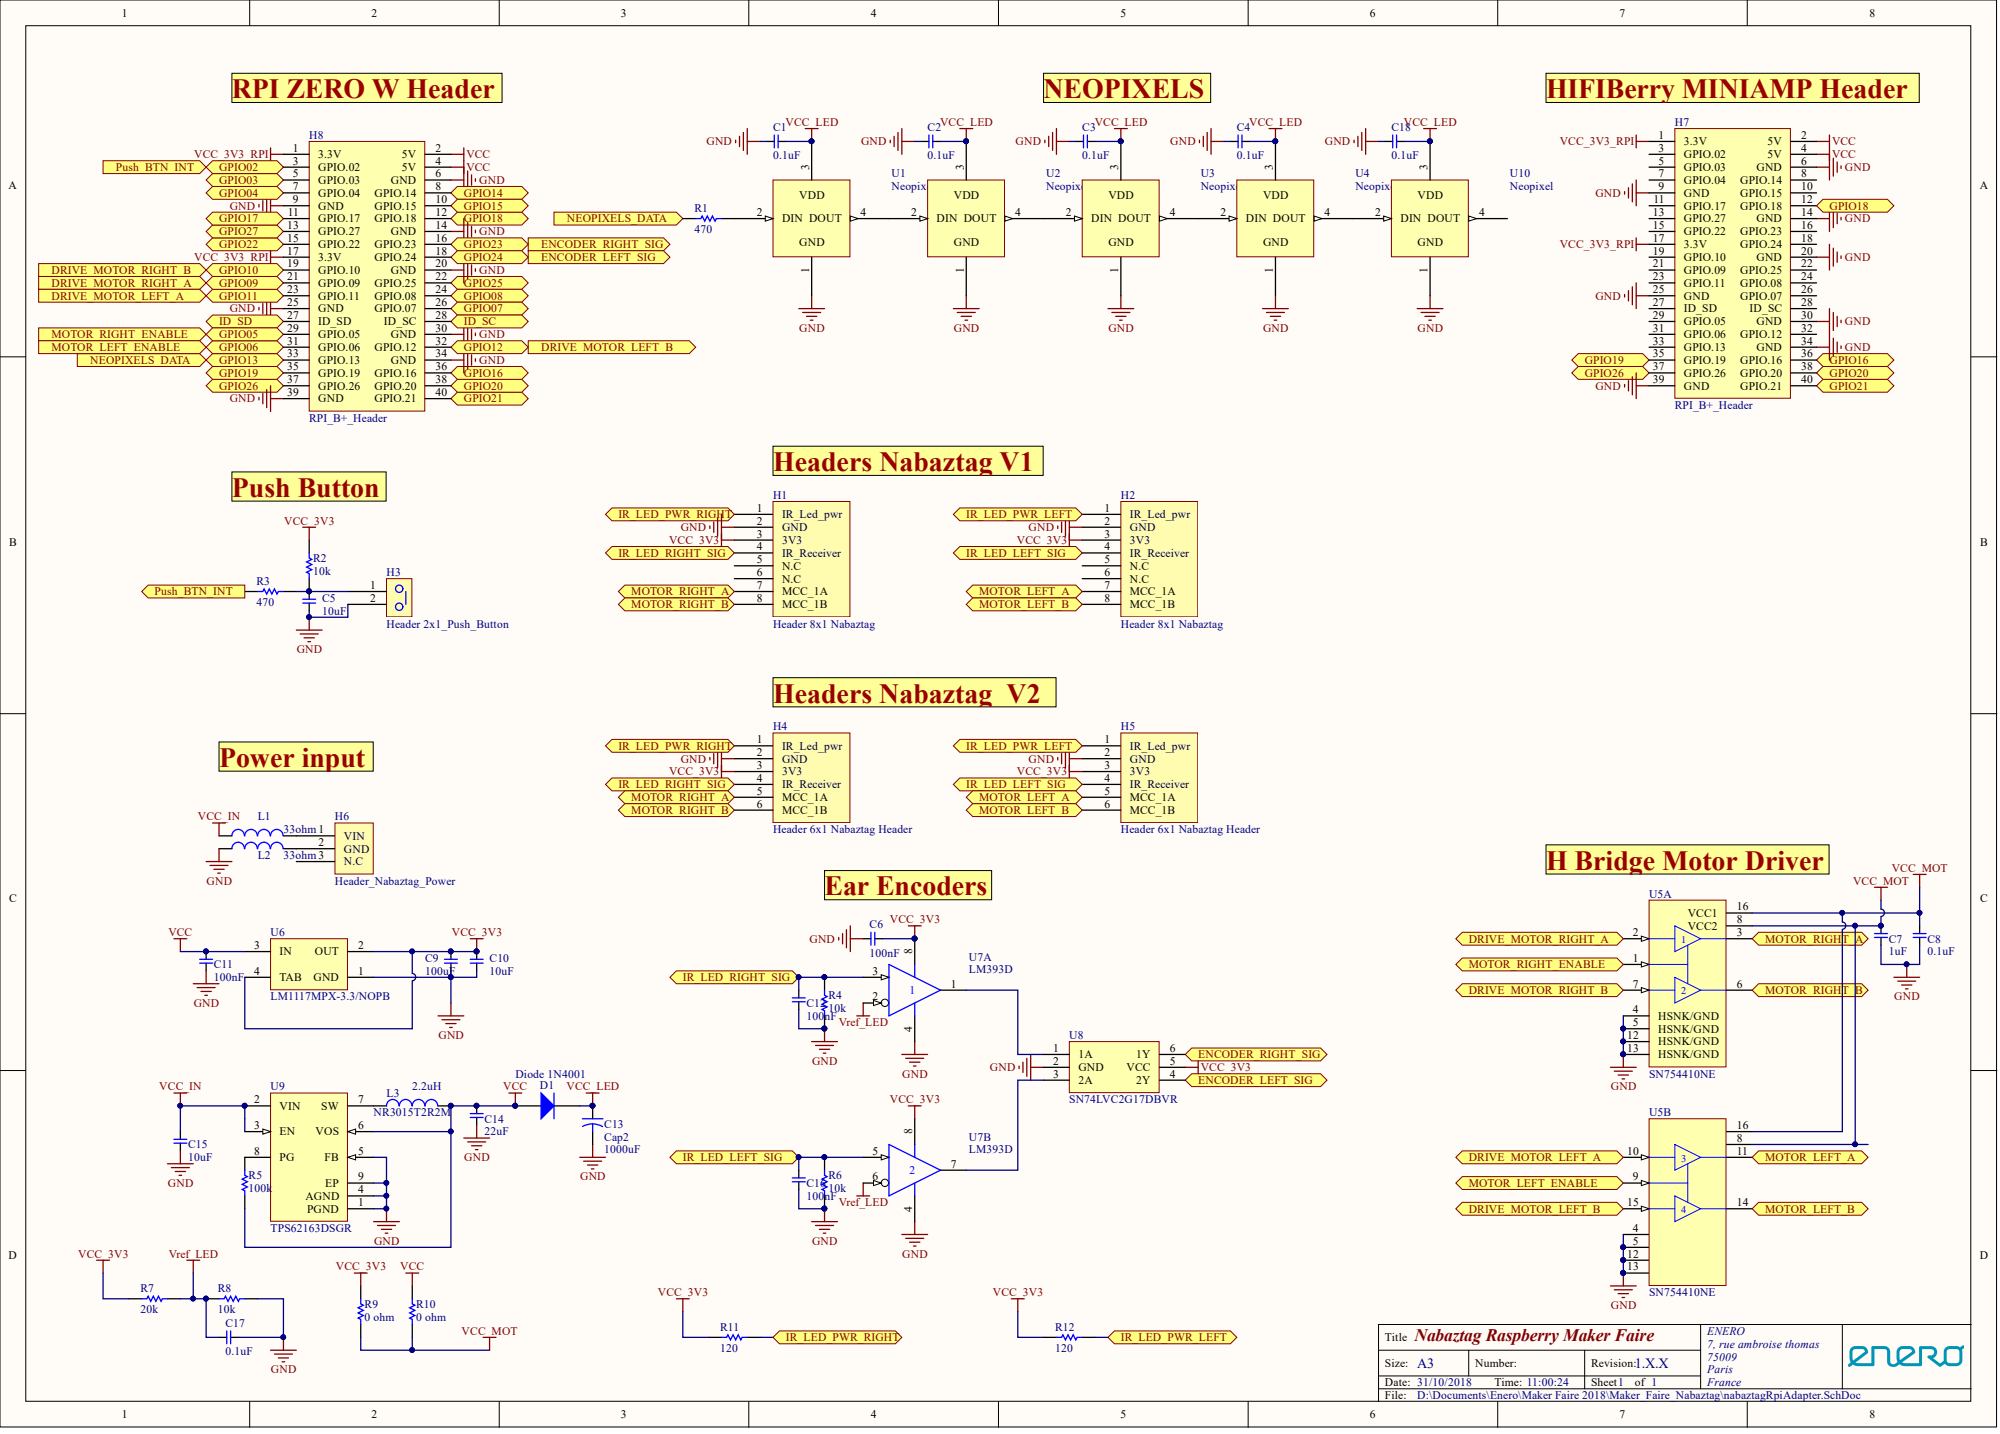
[picture p15: page 1]

Nabaztag Raspberry Maker Faire Title | ENERO 7, rue ambroise thomas 75009 Paris France

Size: A3 | Number: | Revision: 1.X.X
Date: 31/10/2018 Time: 11:00:24 | | Sheet 1 of 1

D:\Documents\Enero\Maker Faire 2018\Maker_Faire_Nabaztag\nabaztagRpiAdapter.SchDoc

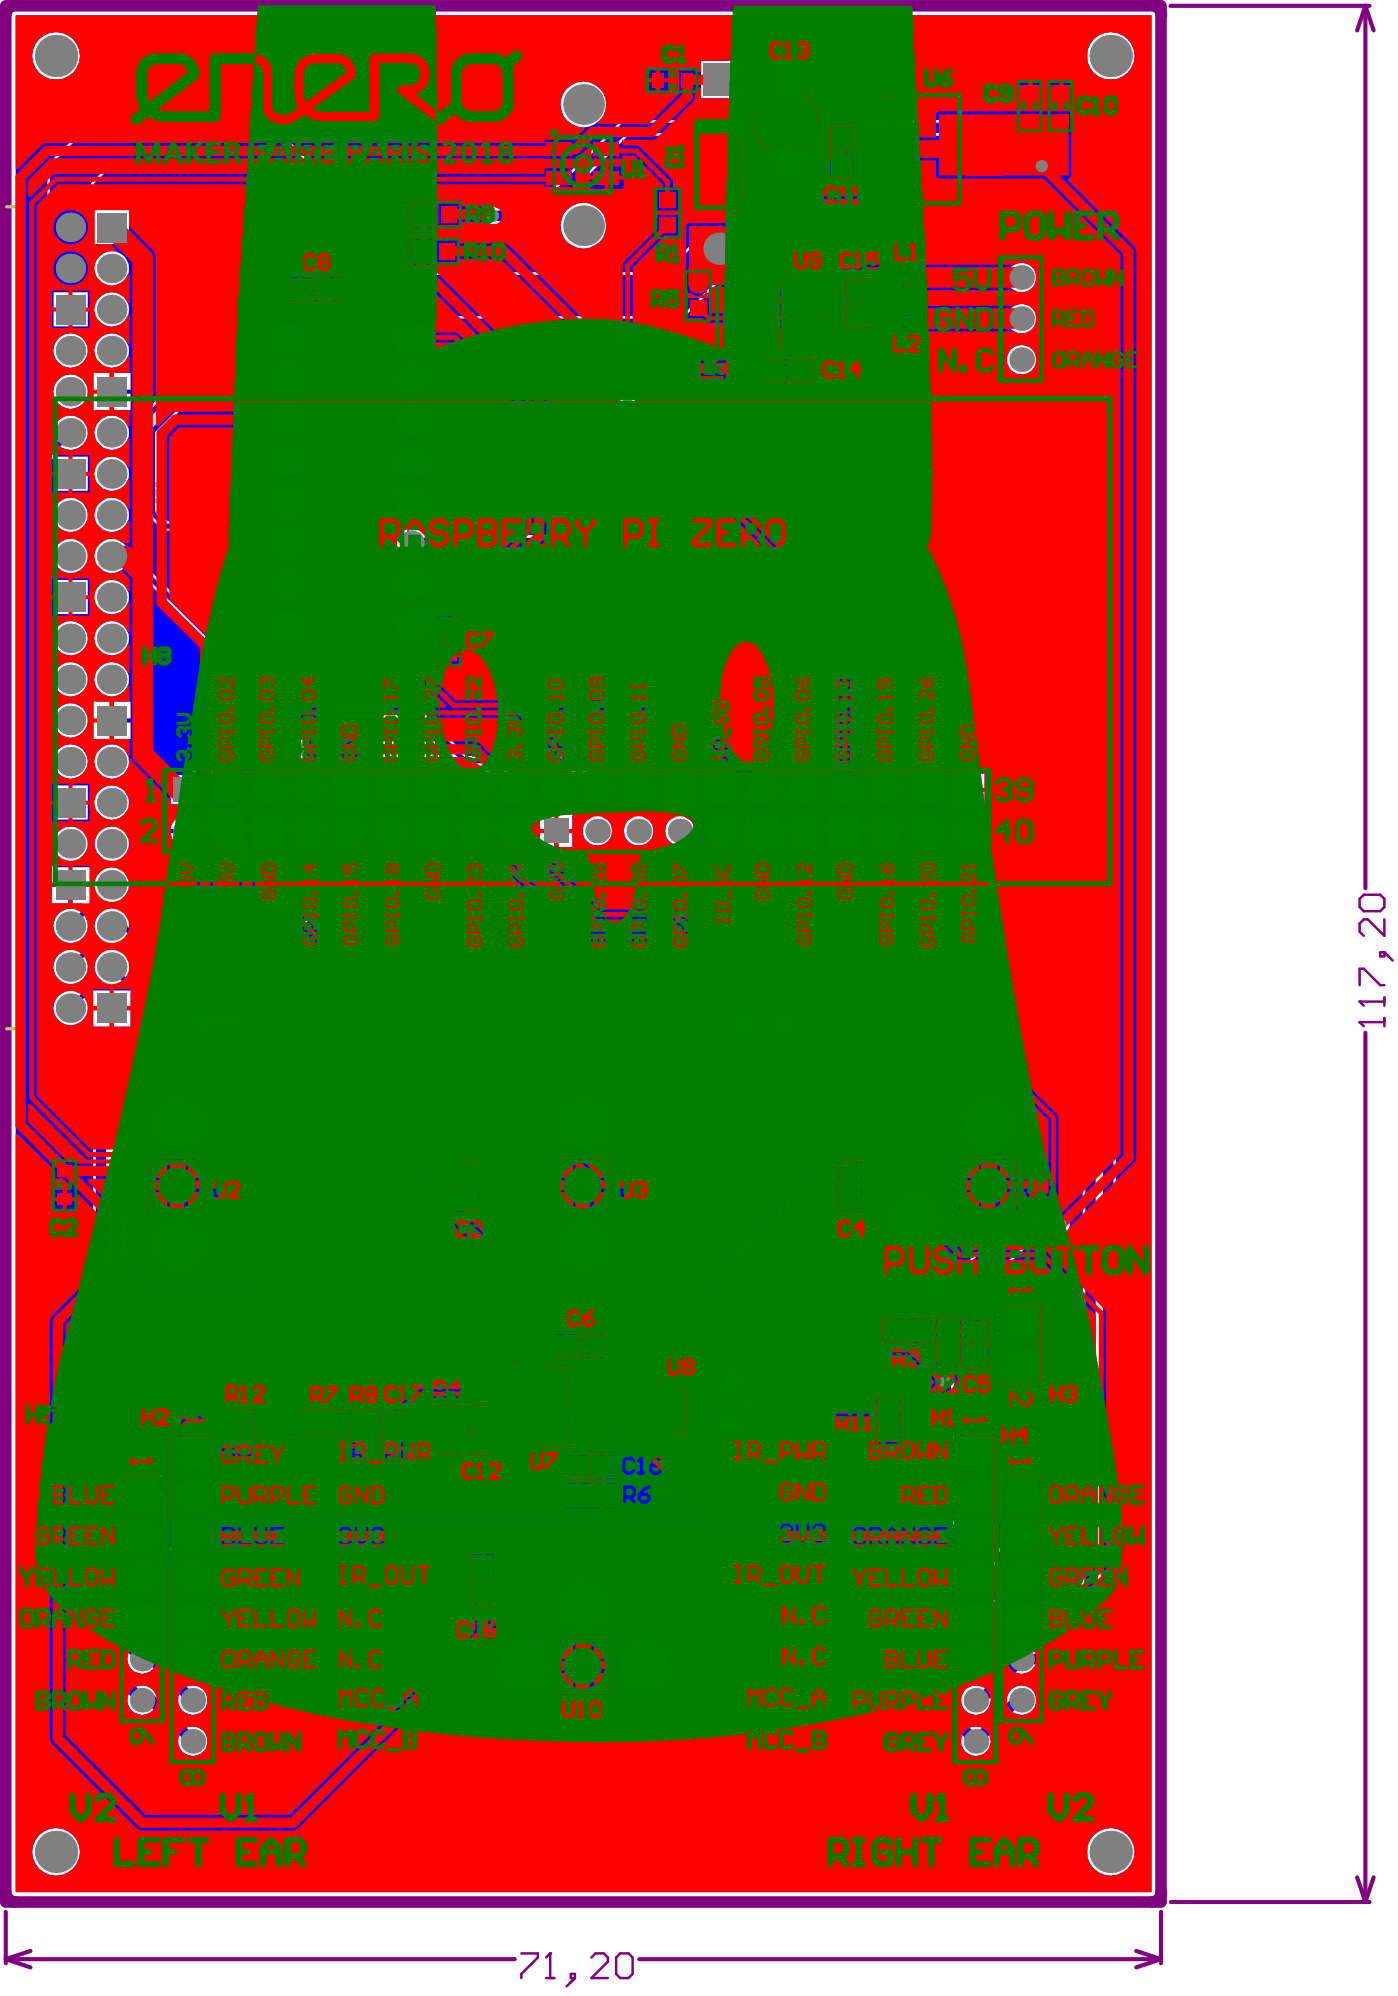
[picture p16: page 2]

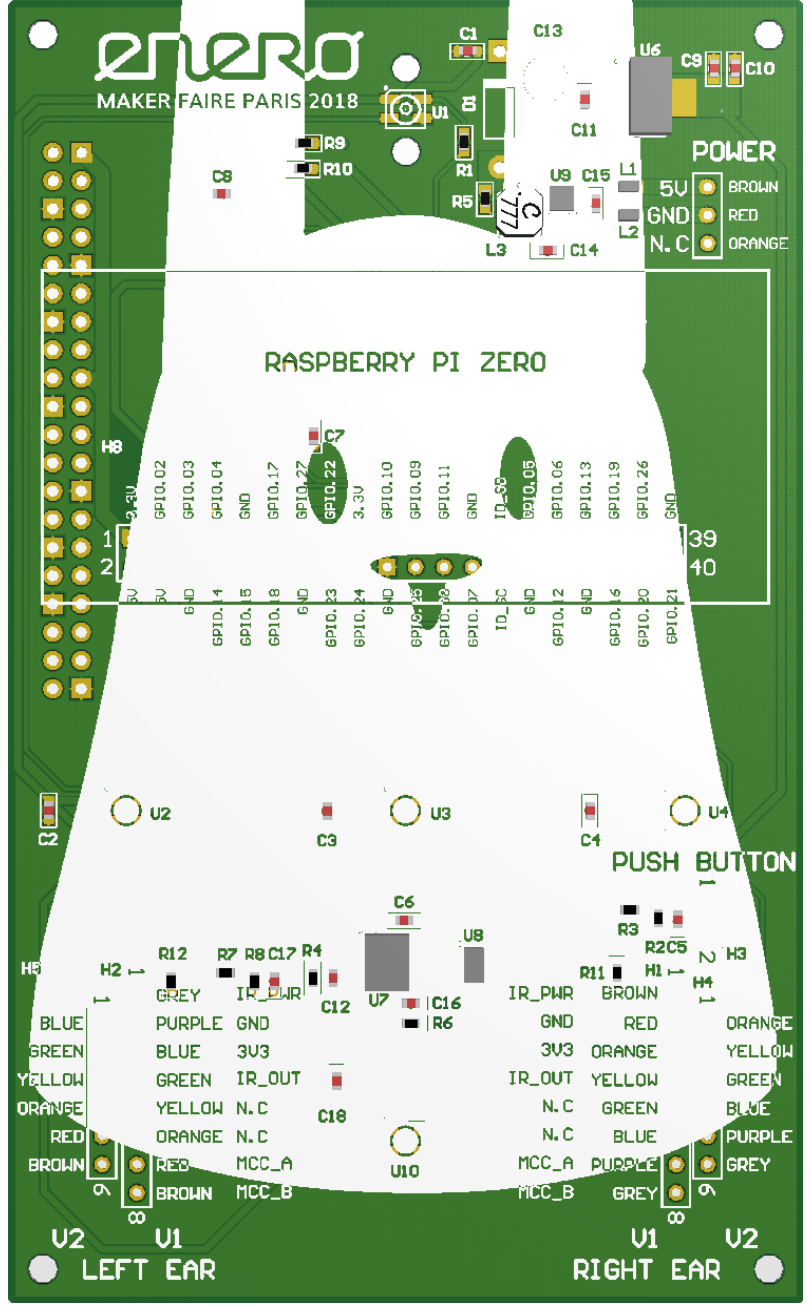
[picture p17: page 3]
