nabaztag2018/hardware/legacy/pyNab_V2.PDF

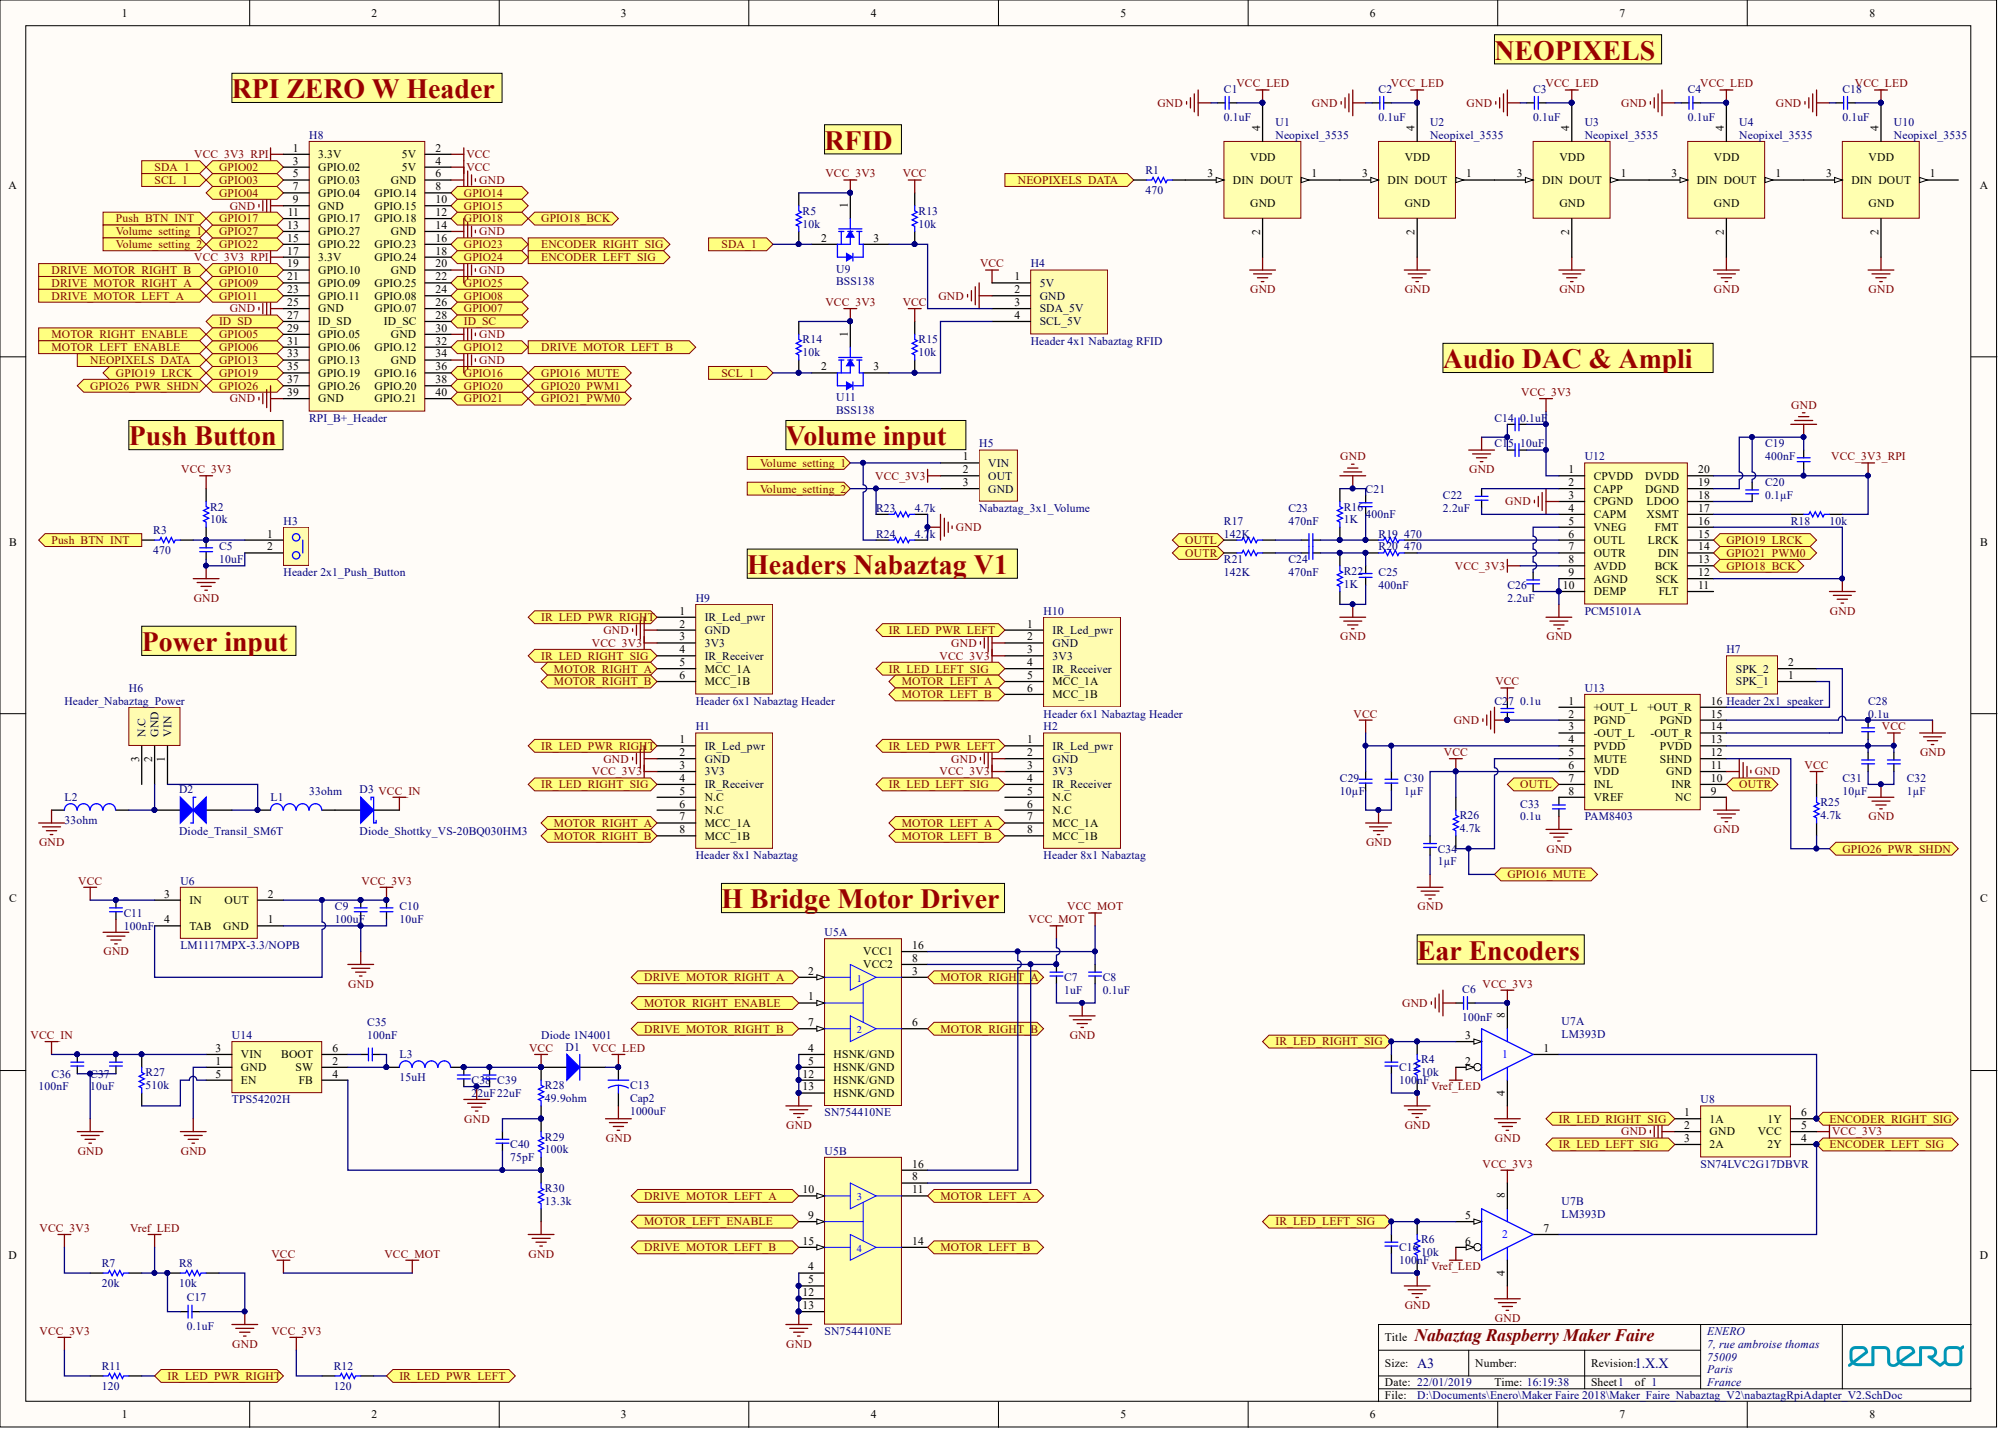
[picture p18: page 1]

Nabaztag Raspberry Maker Faire Title | ENERO 7, rue ambroise thomas 75009 Paris France

Size: A3 | Number: | Revision: 1.X.X
Date: 22/01/2019 Time: 16:19:38 | | Sheet 1 of 1

D:\Documents\Enero\Maker Faire 2018\Maker_Faire_Nabaztag_V2\nabaztagRpiAdapter_V2.SchDoc

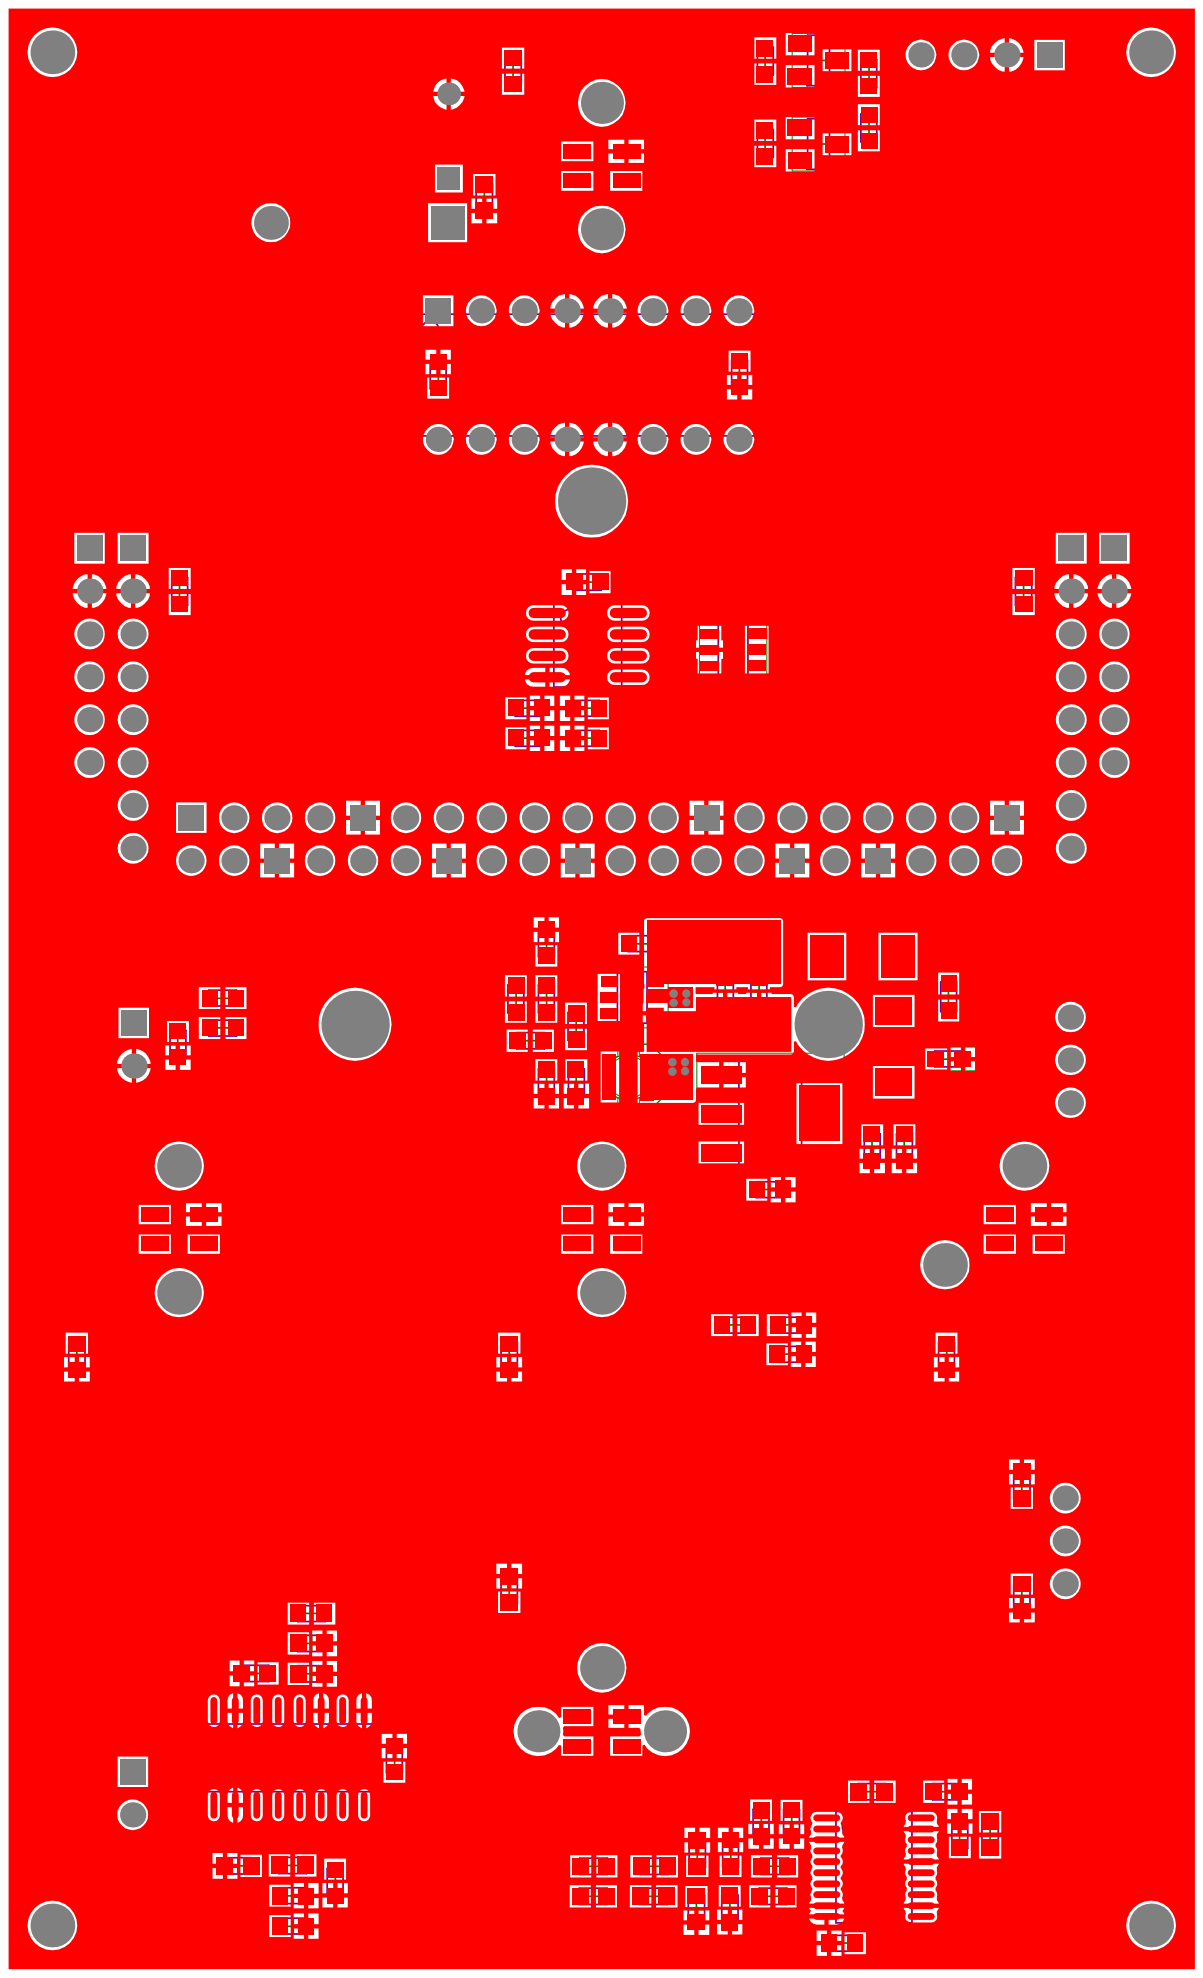
[picture p19: page 2]

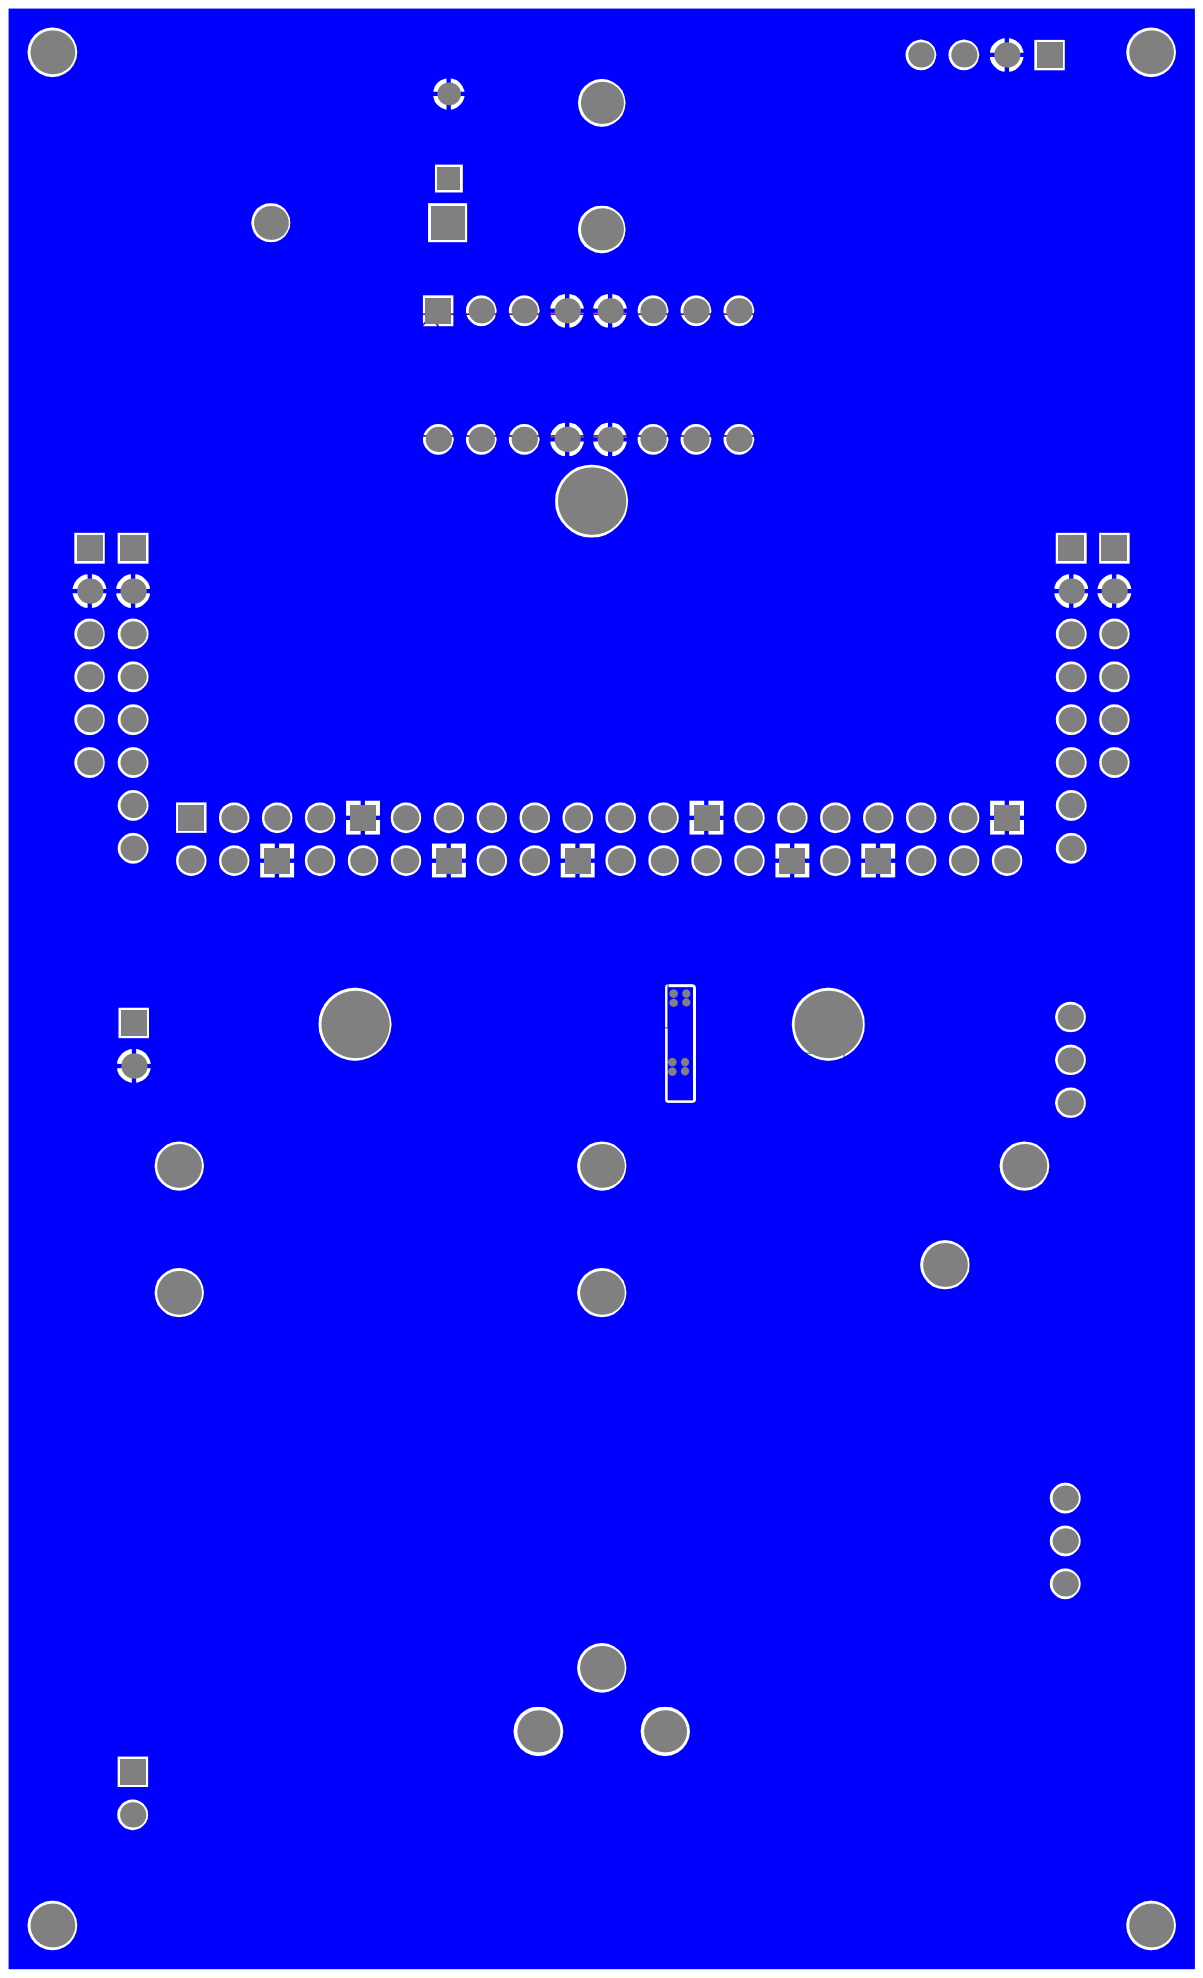
[picture p20: page 3]

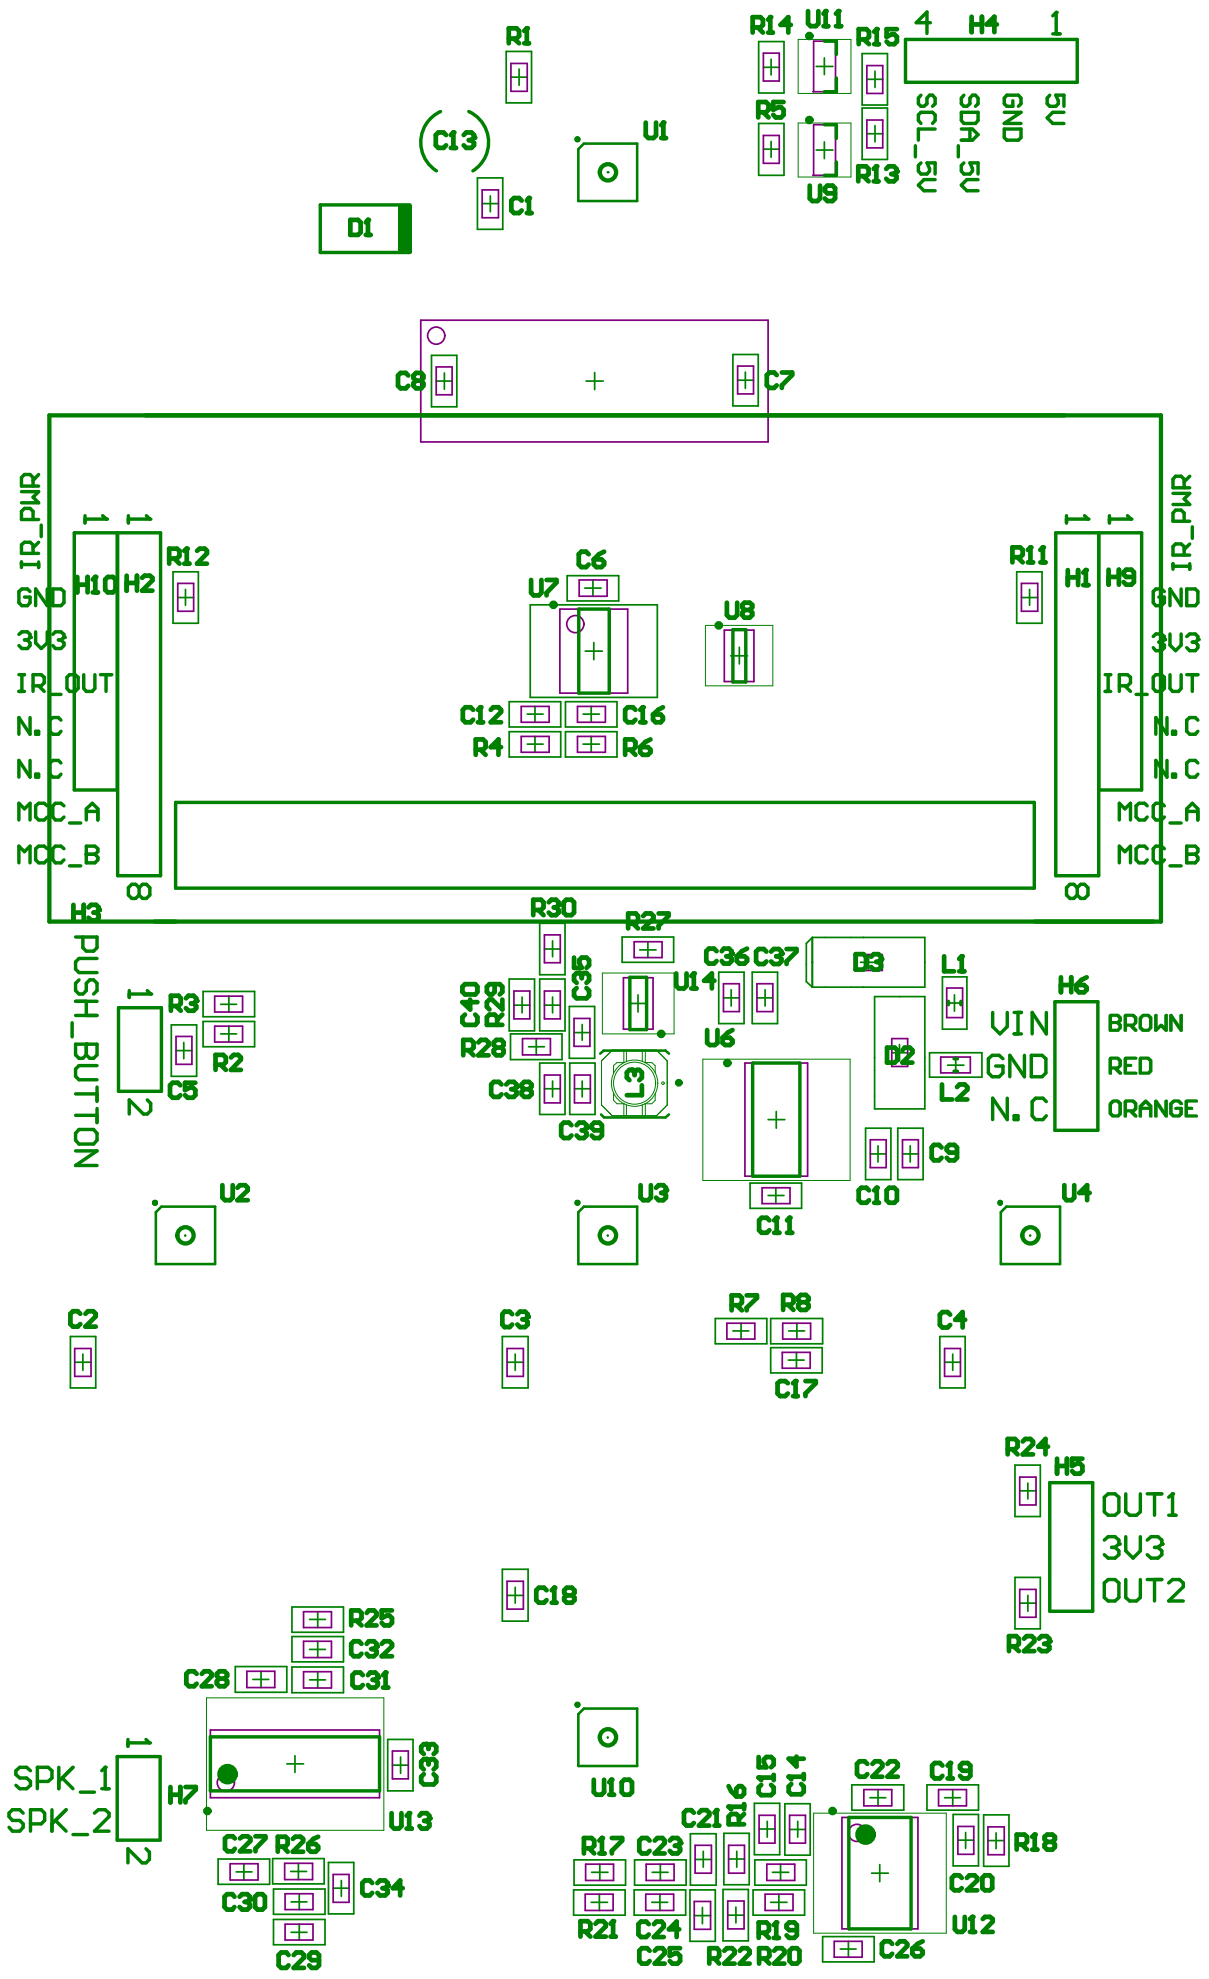
[picture p21: page 4]

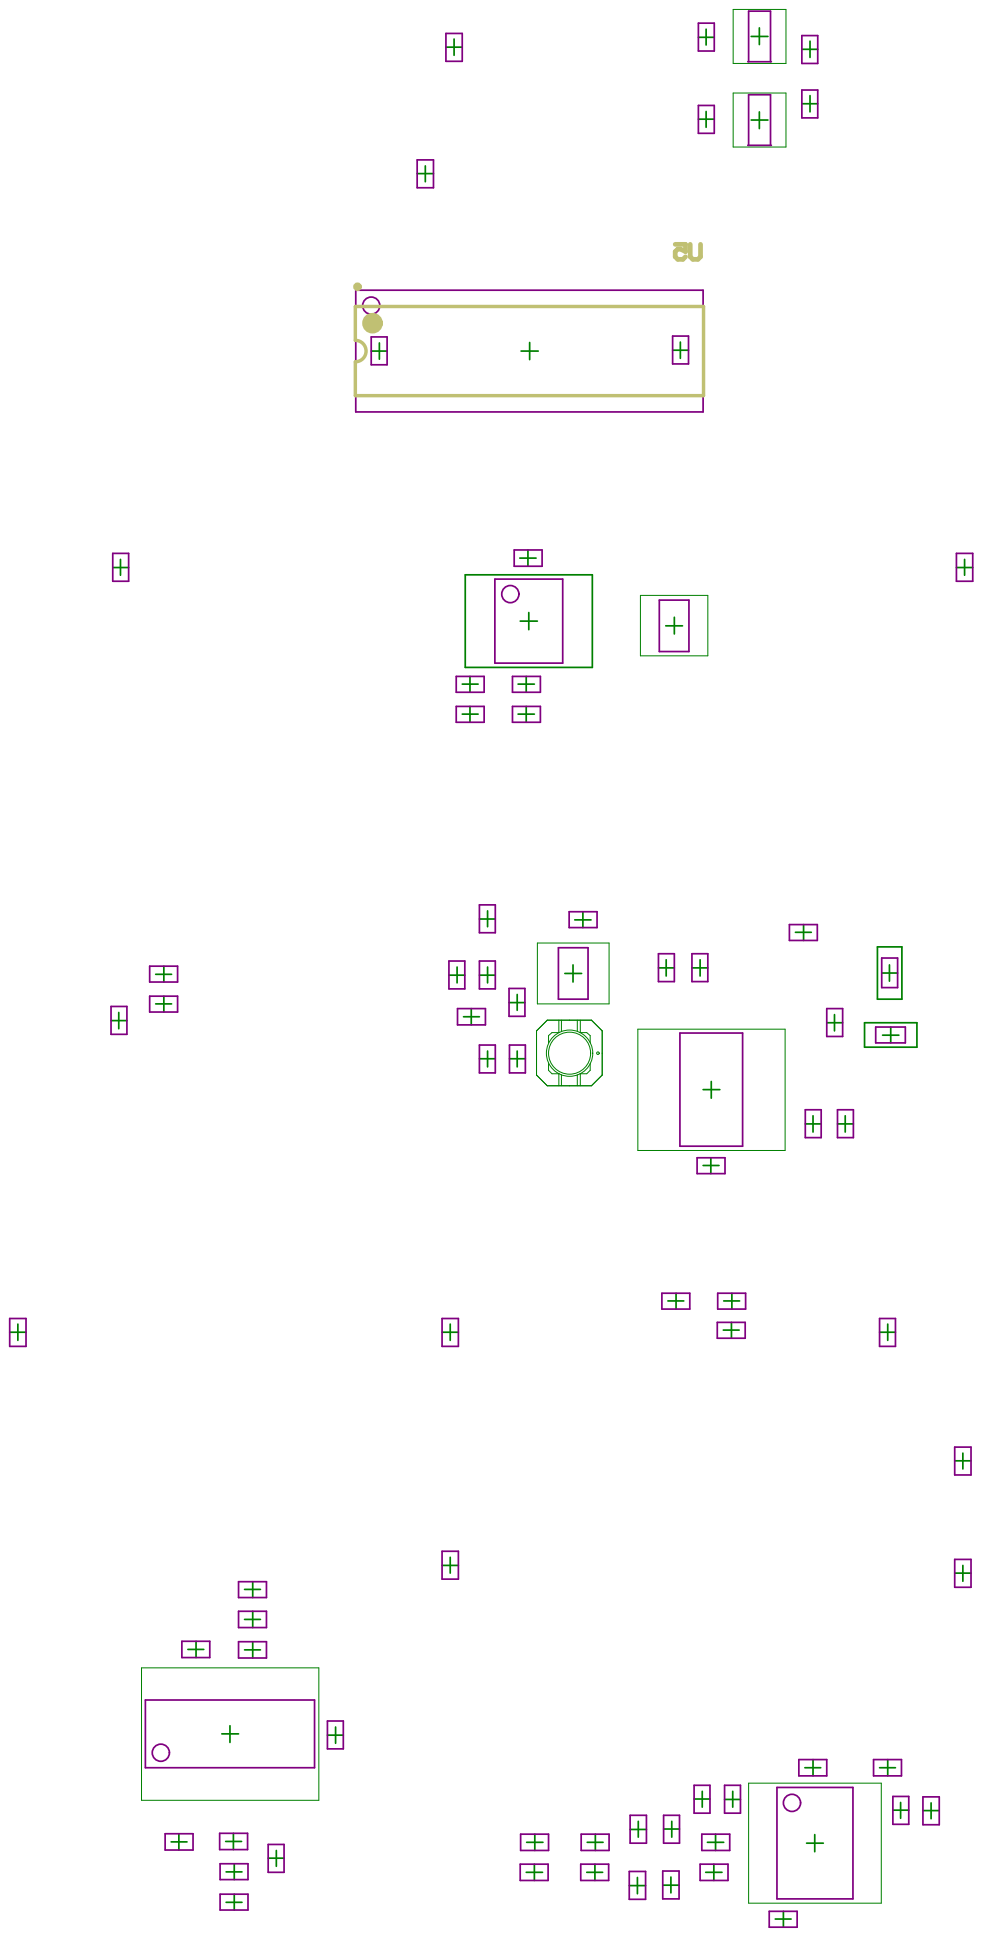
[picture p22: page 5]

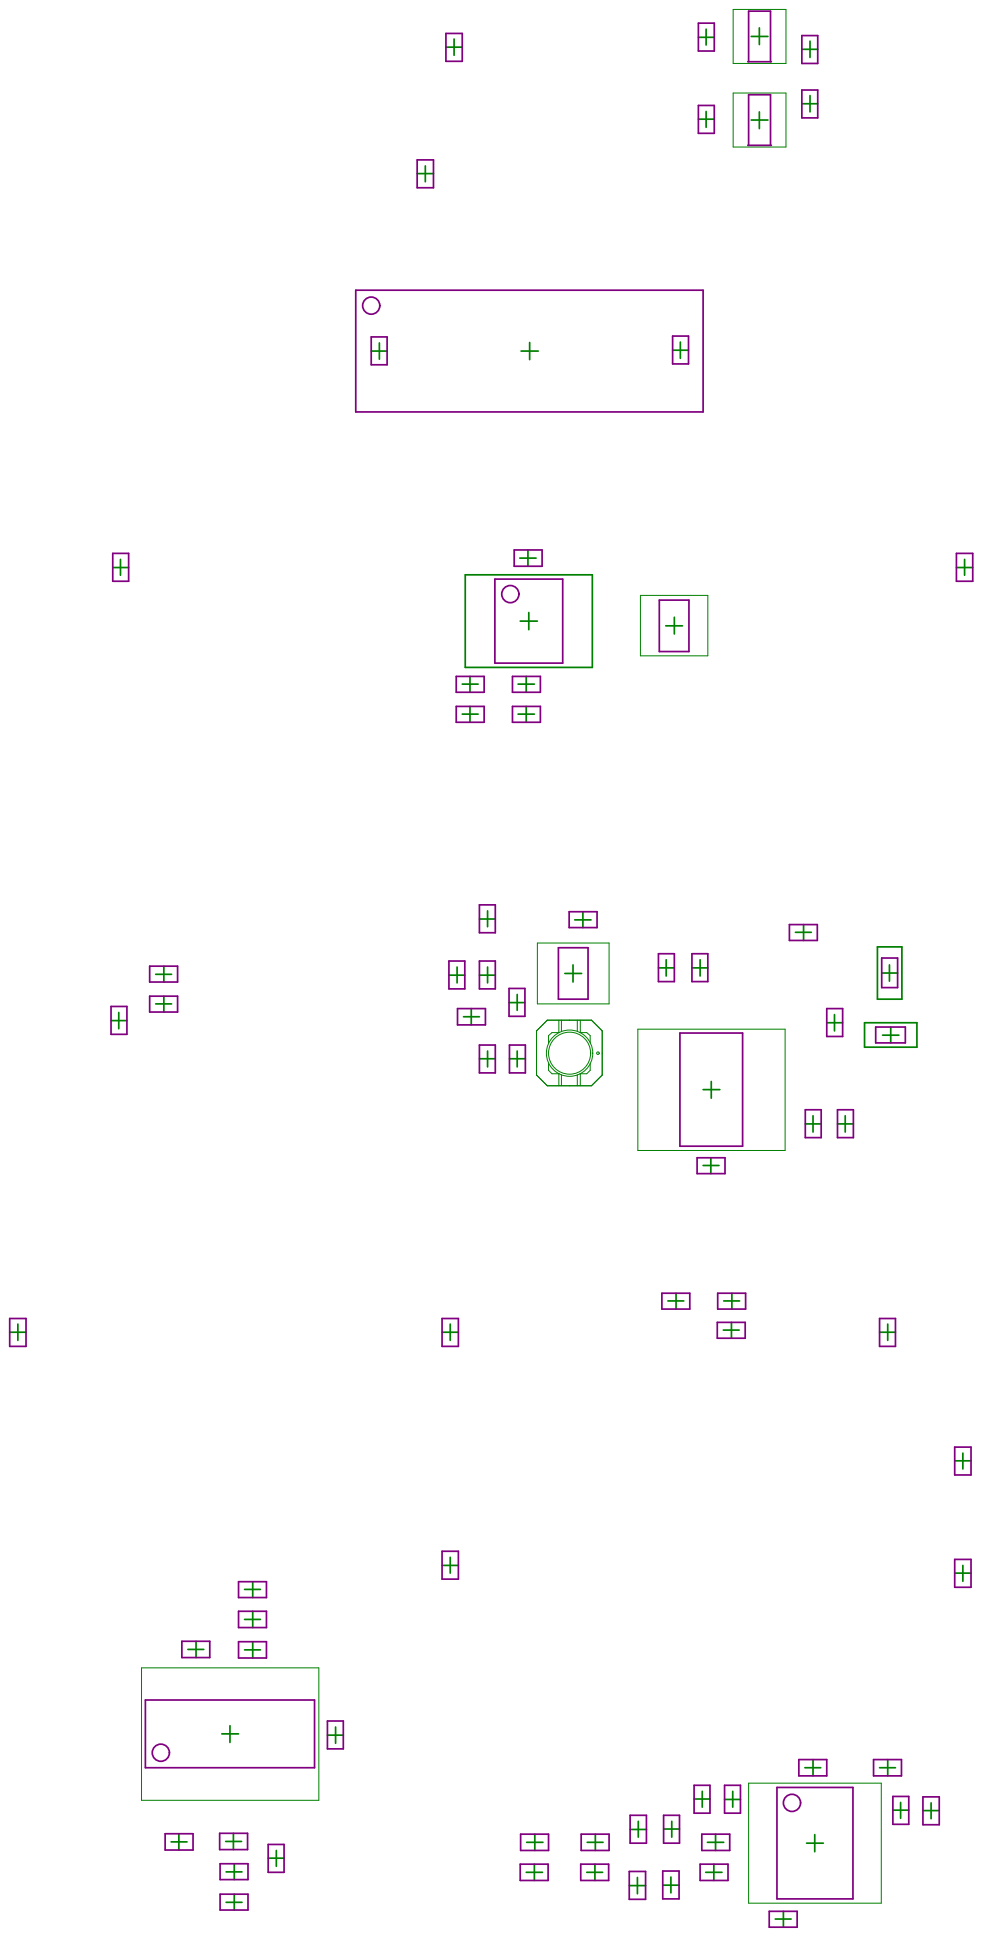
[picture p23: page 6]

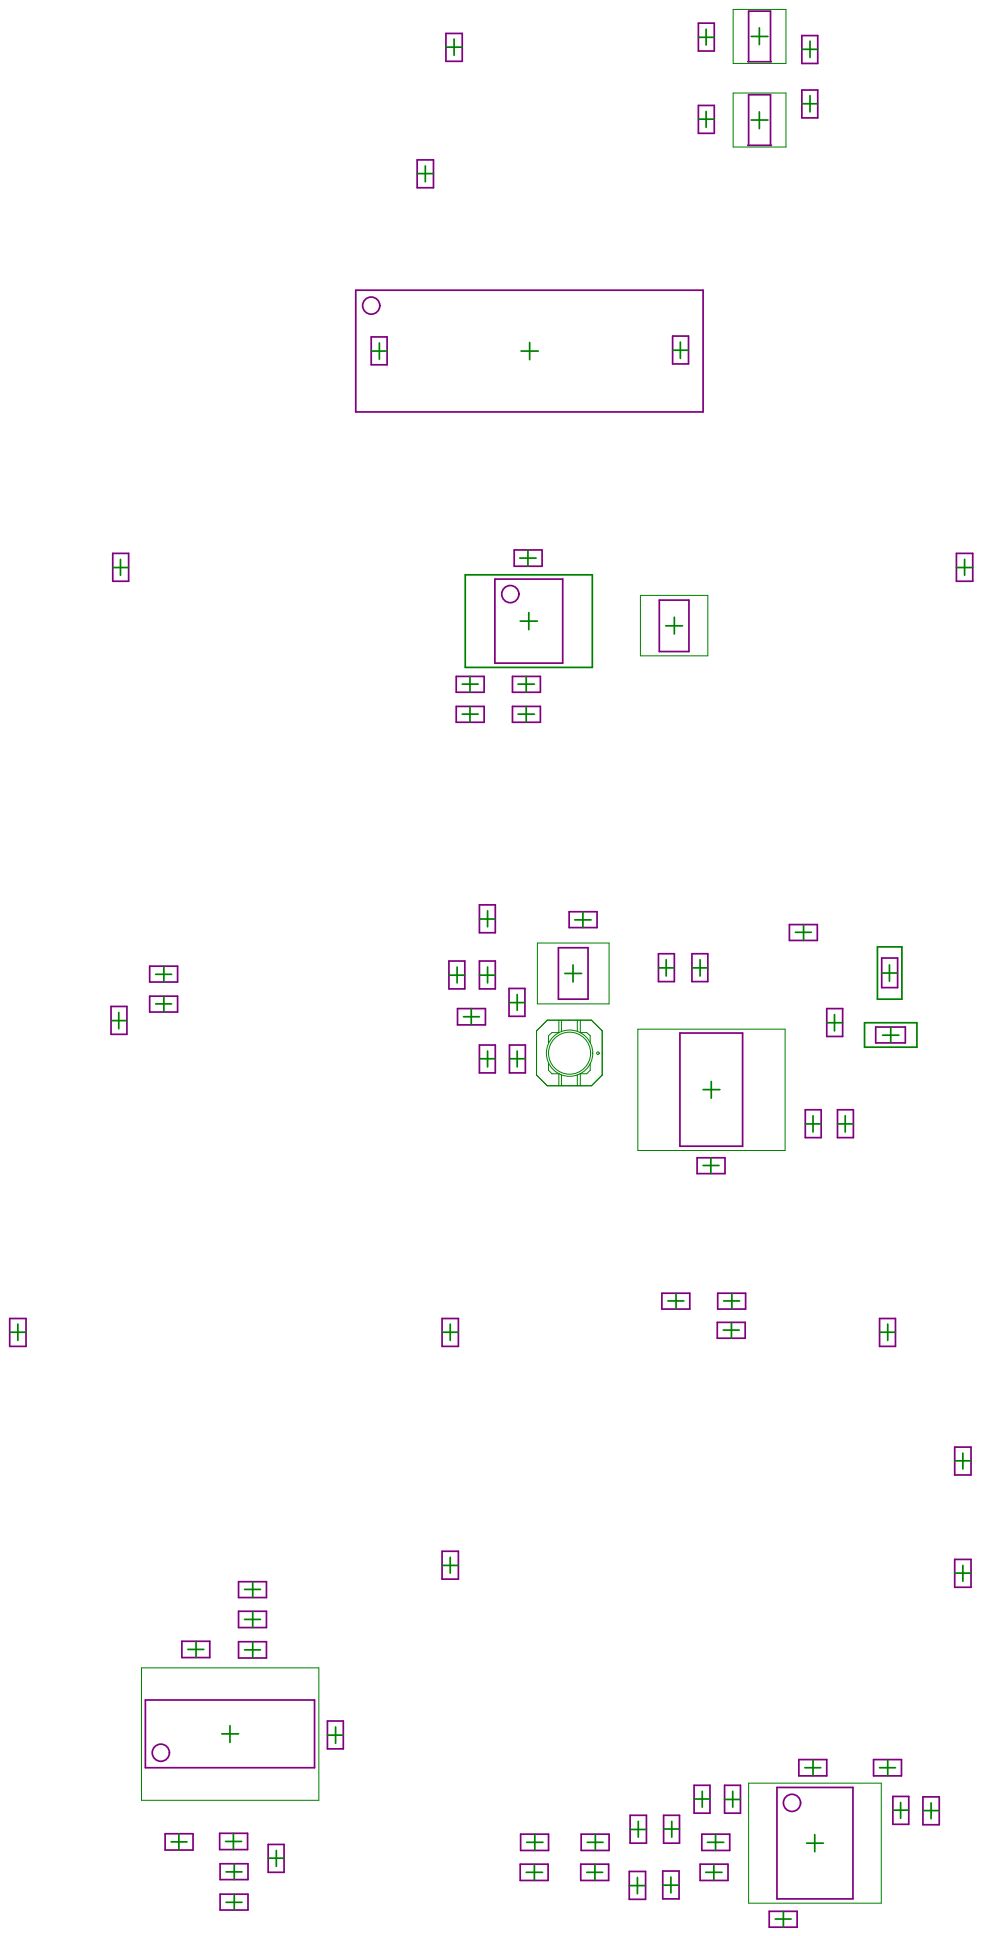
[picture p24: page 8]

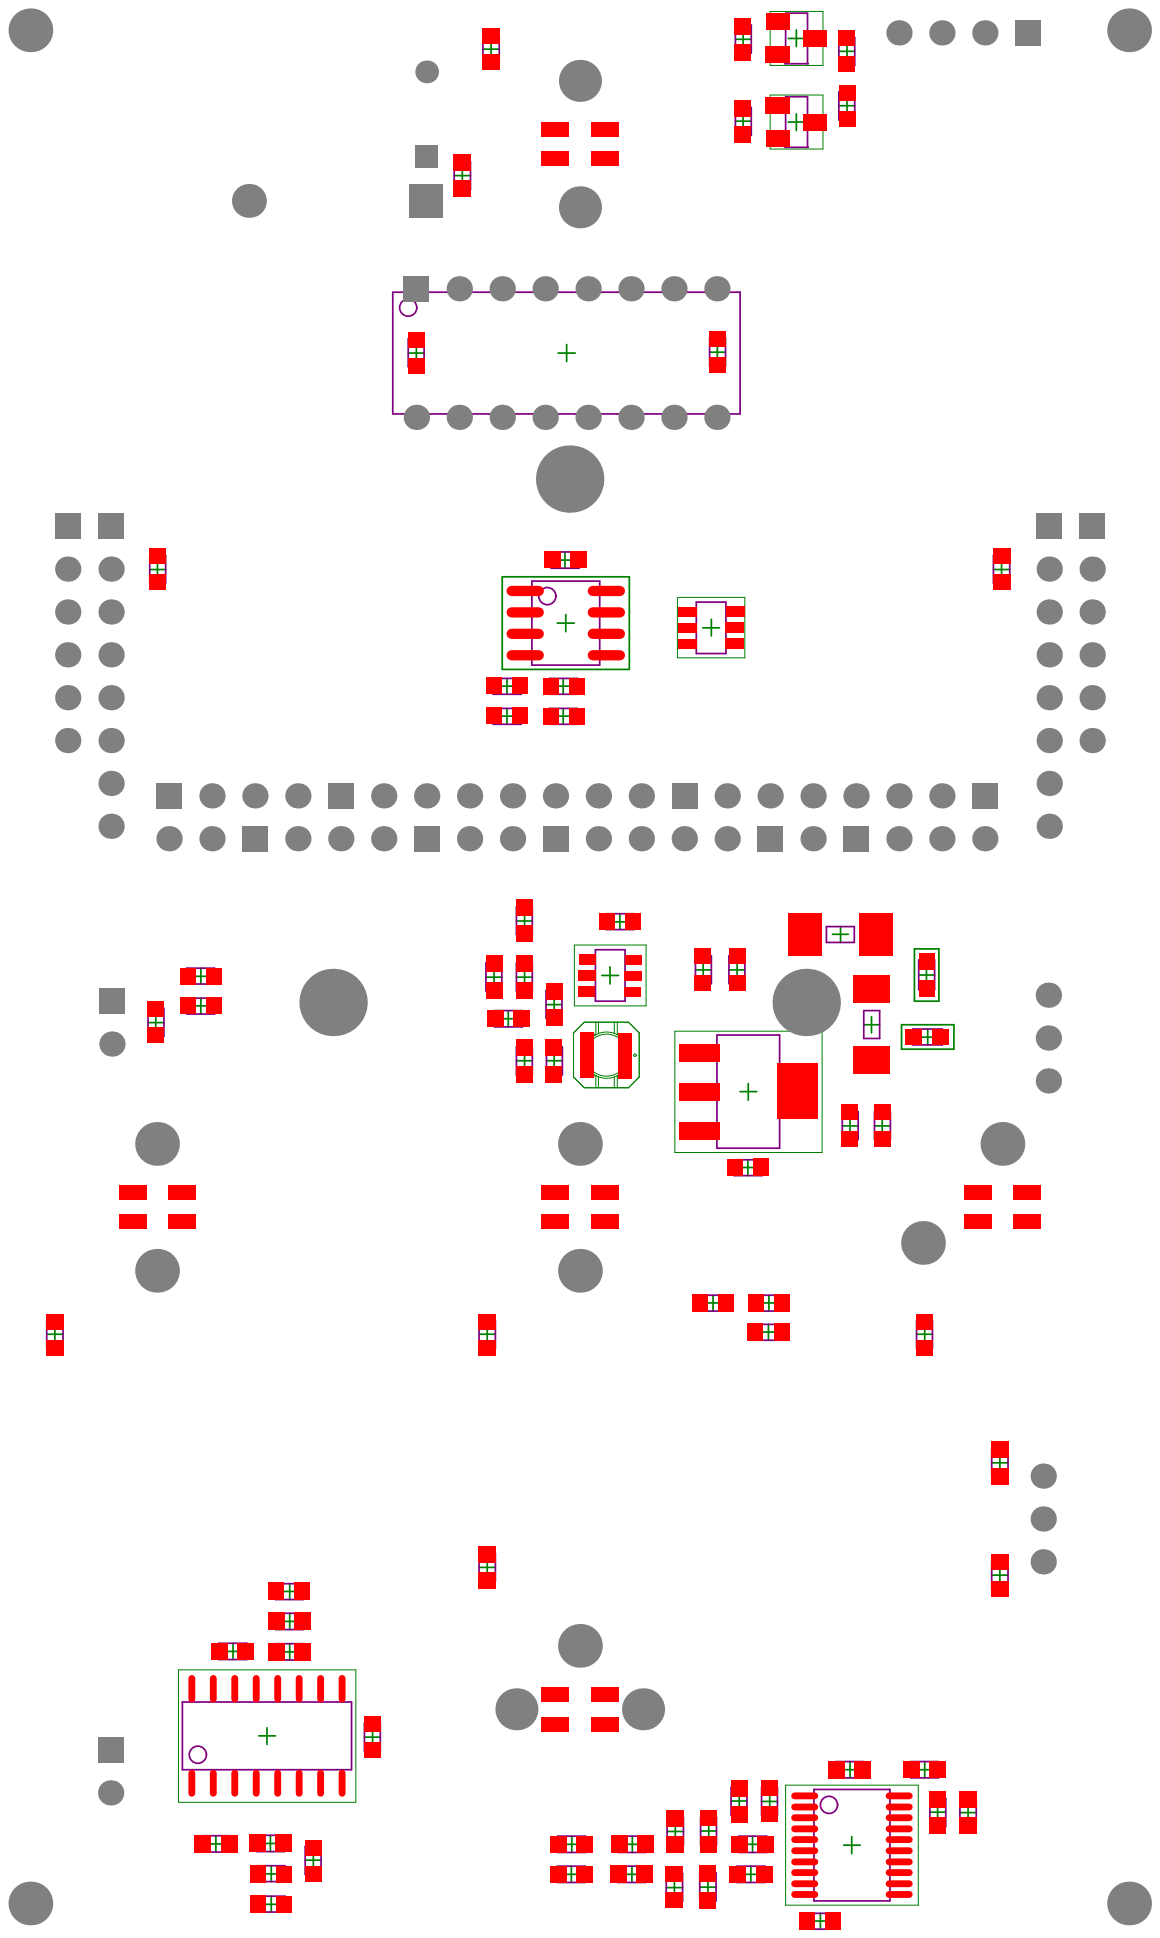
[picture p25: page 9]

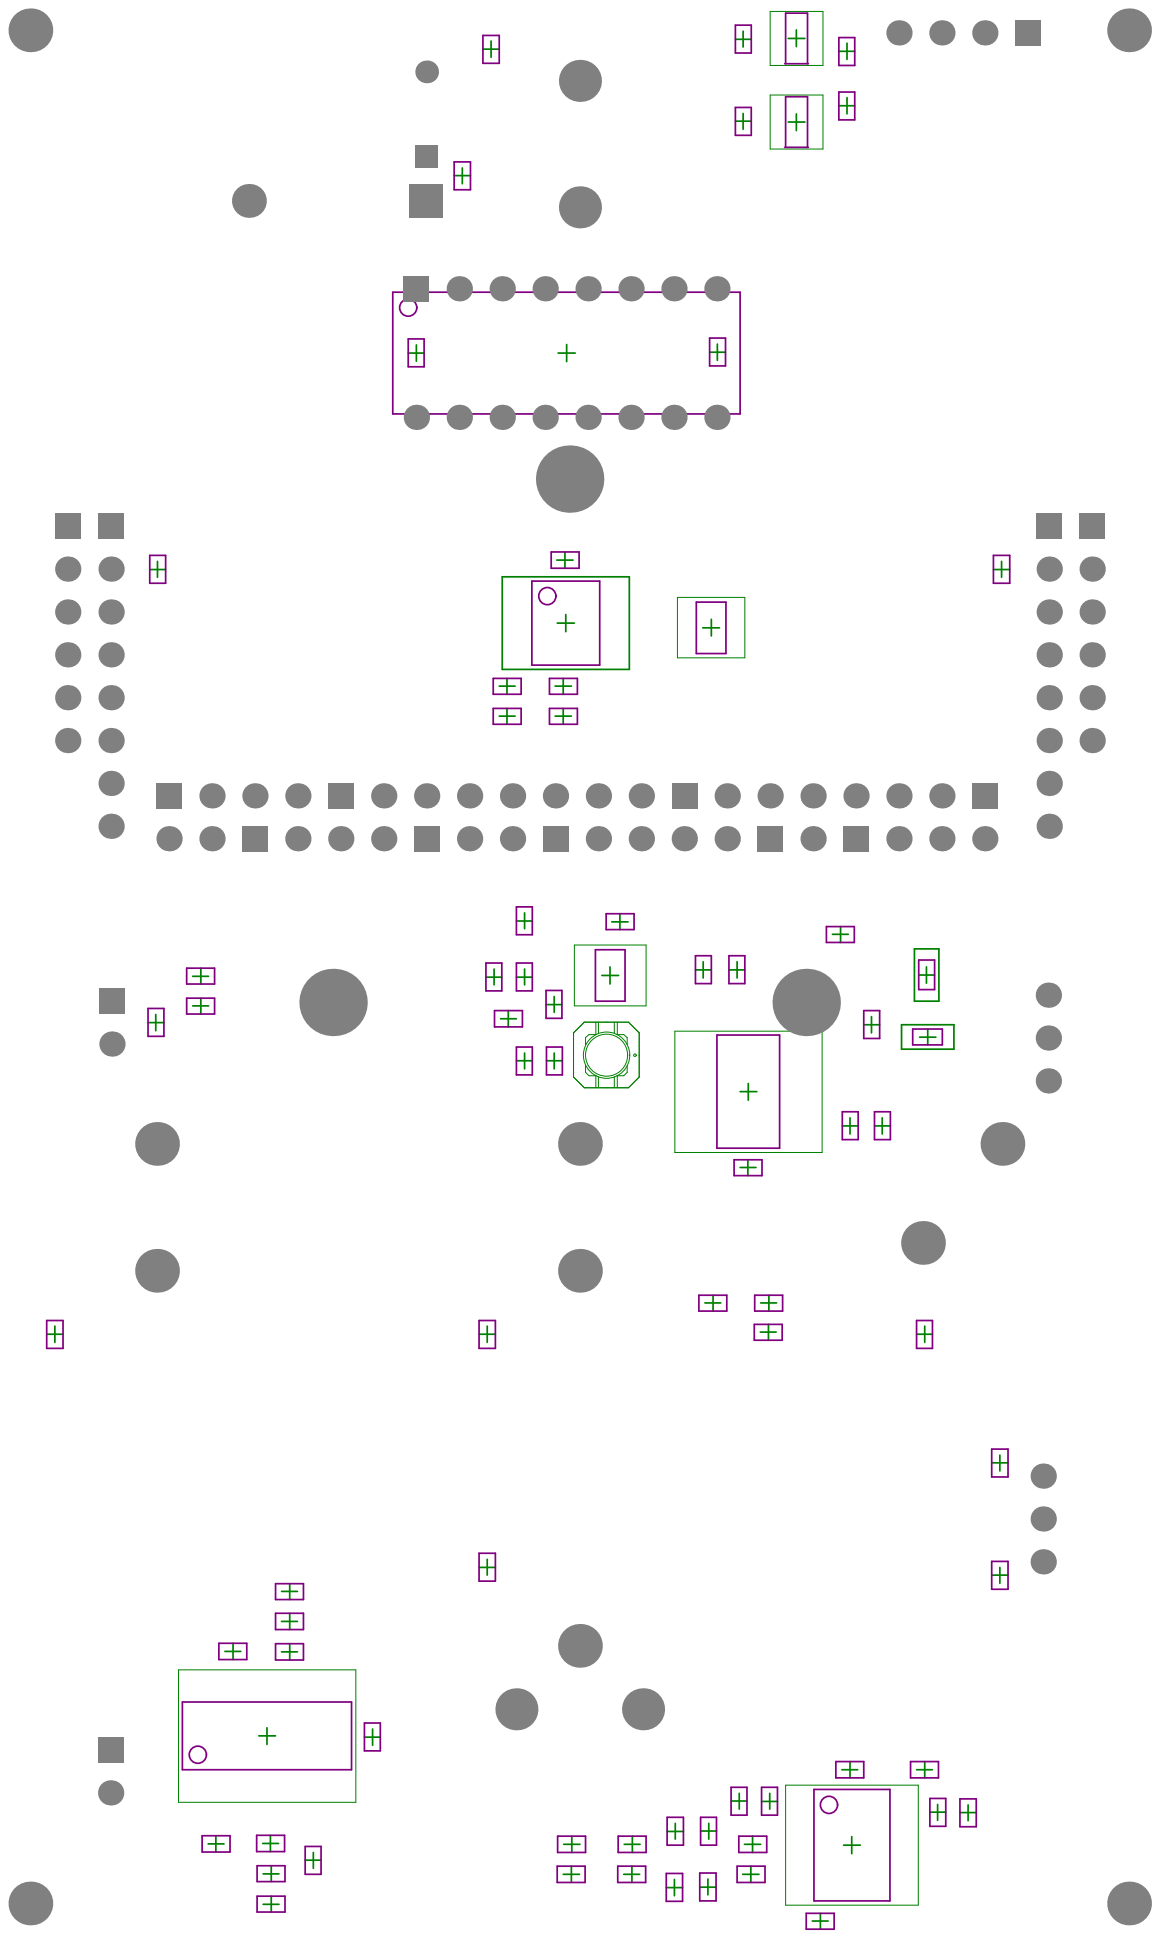
[picture p26: page 10]

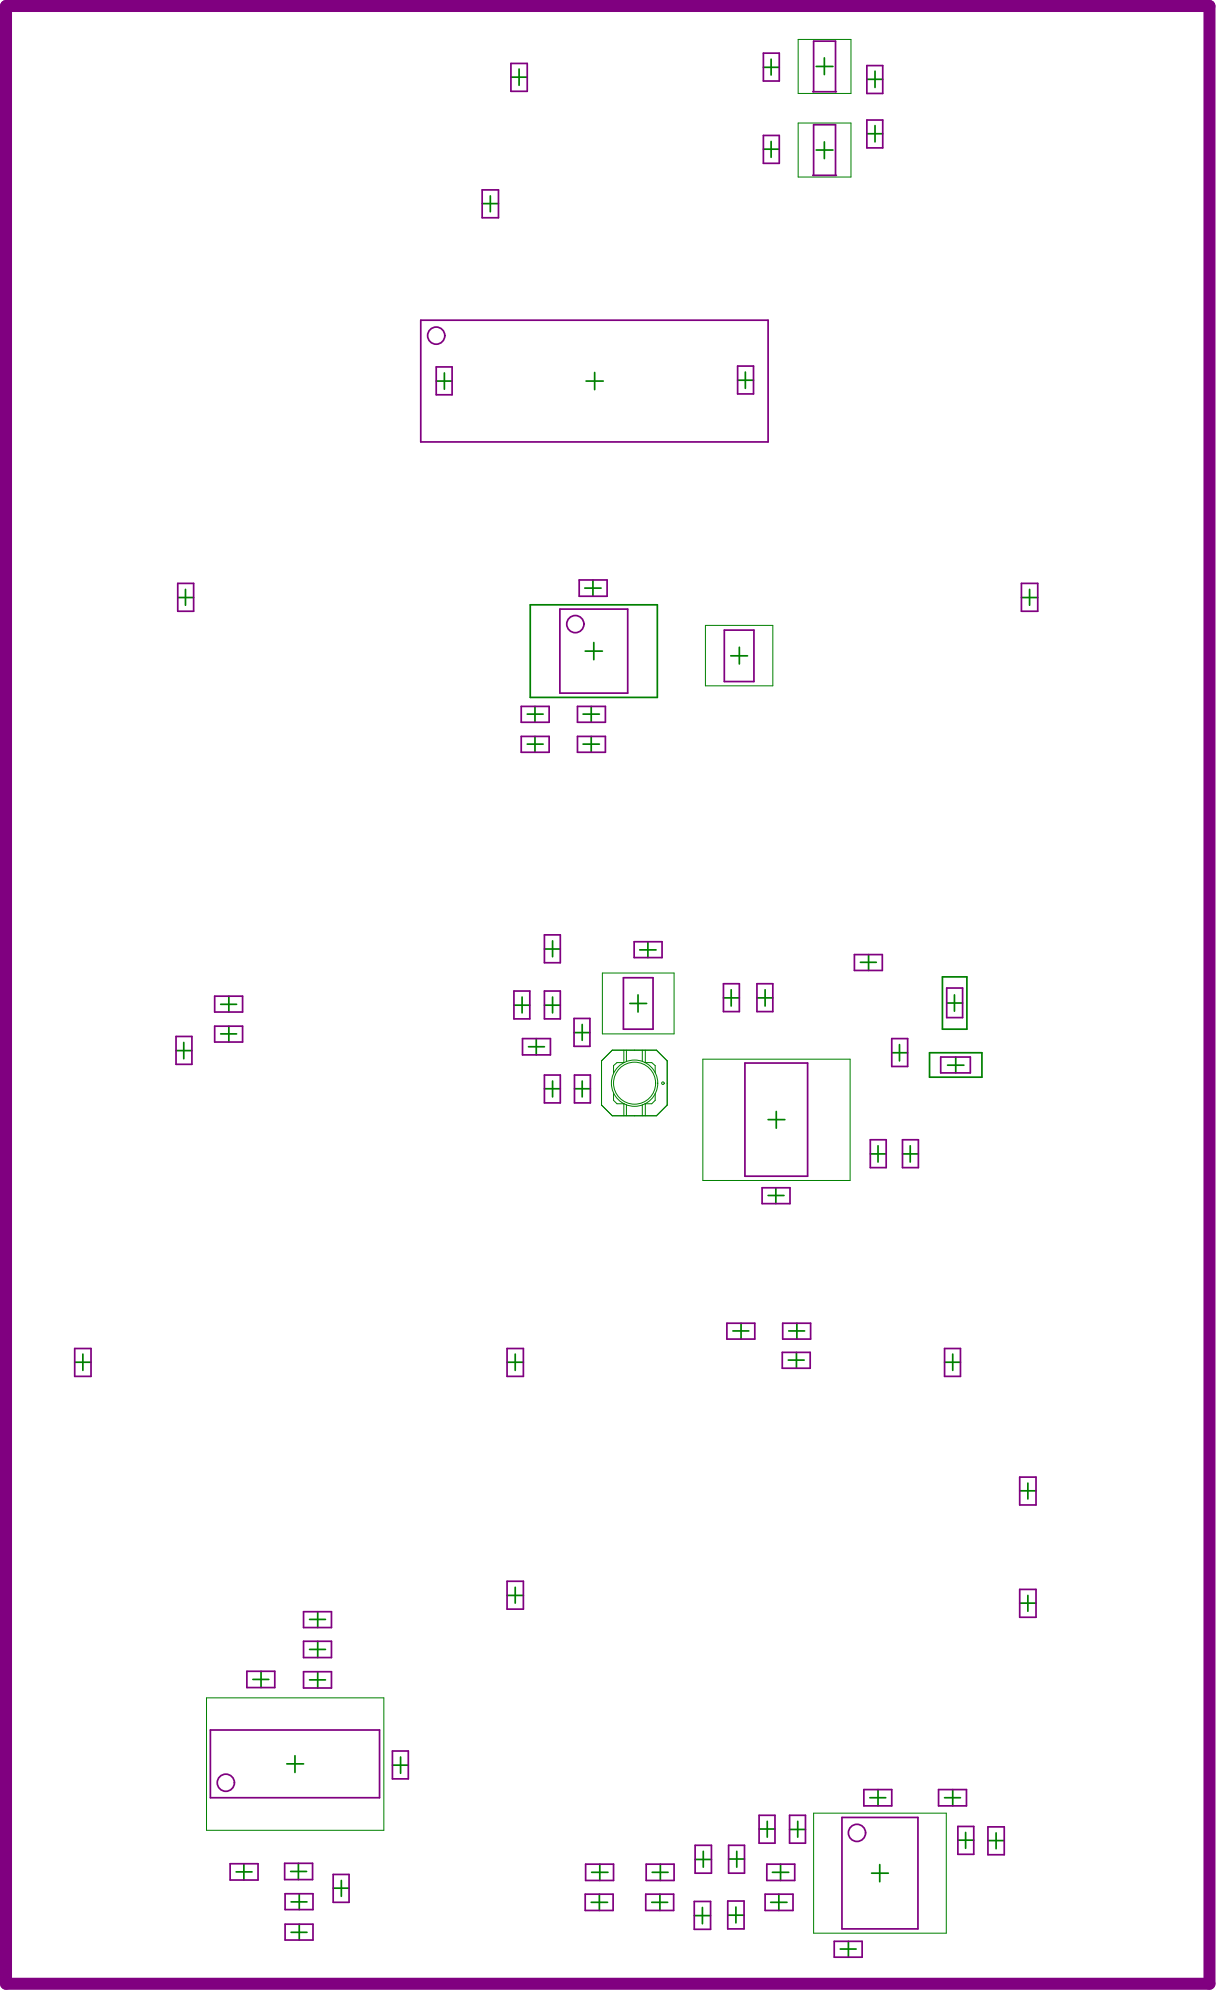
[picture p27: page 11]

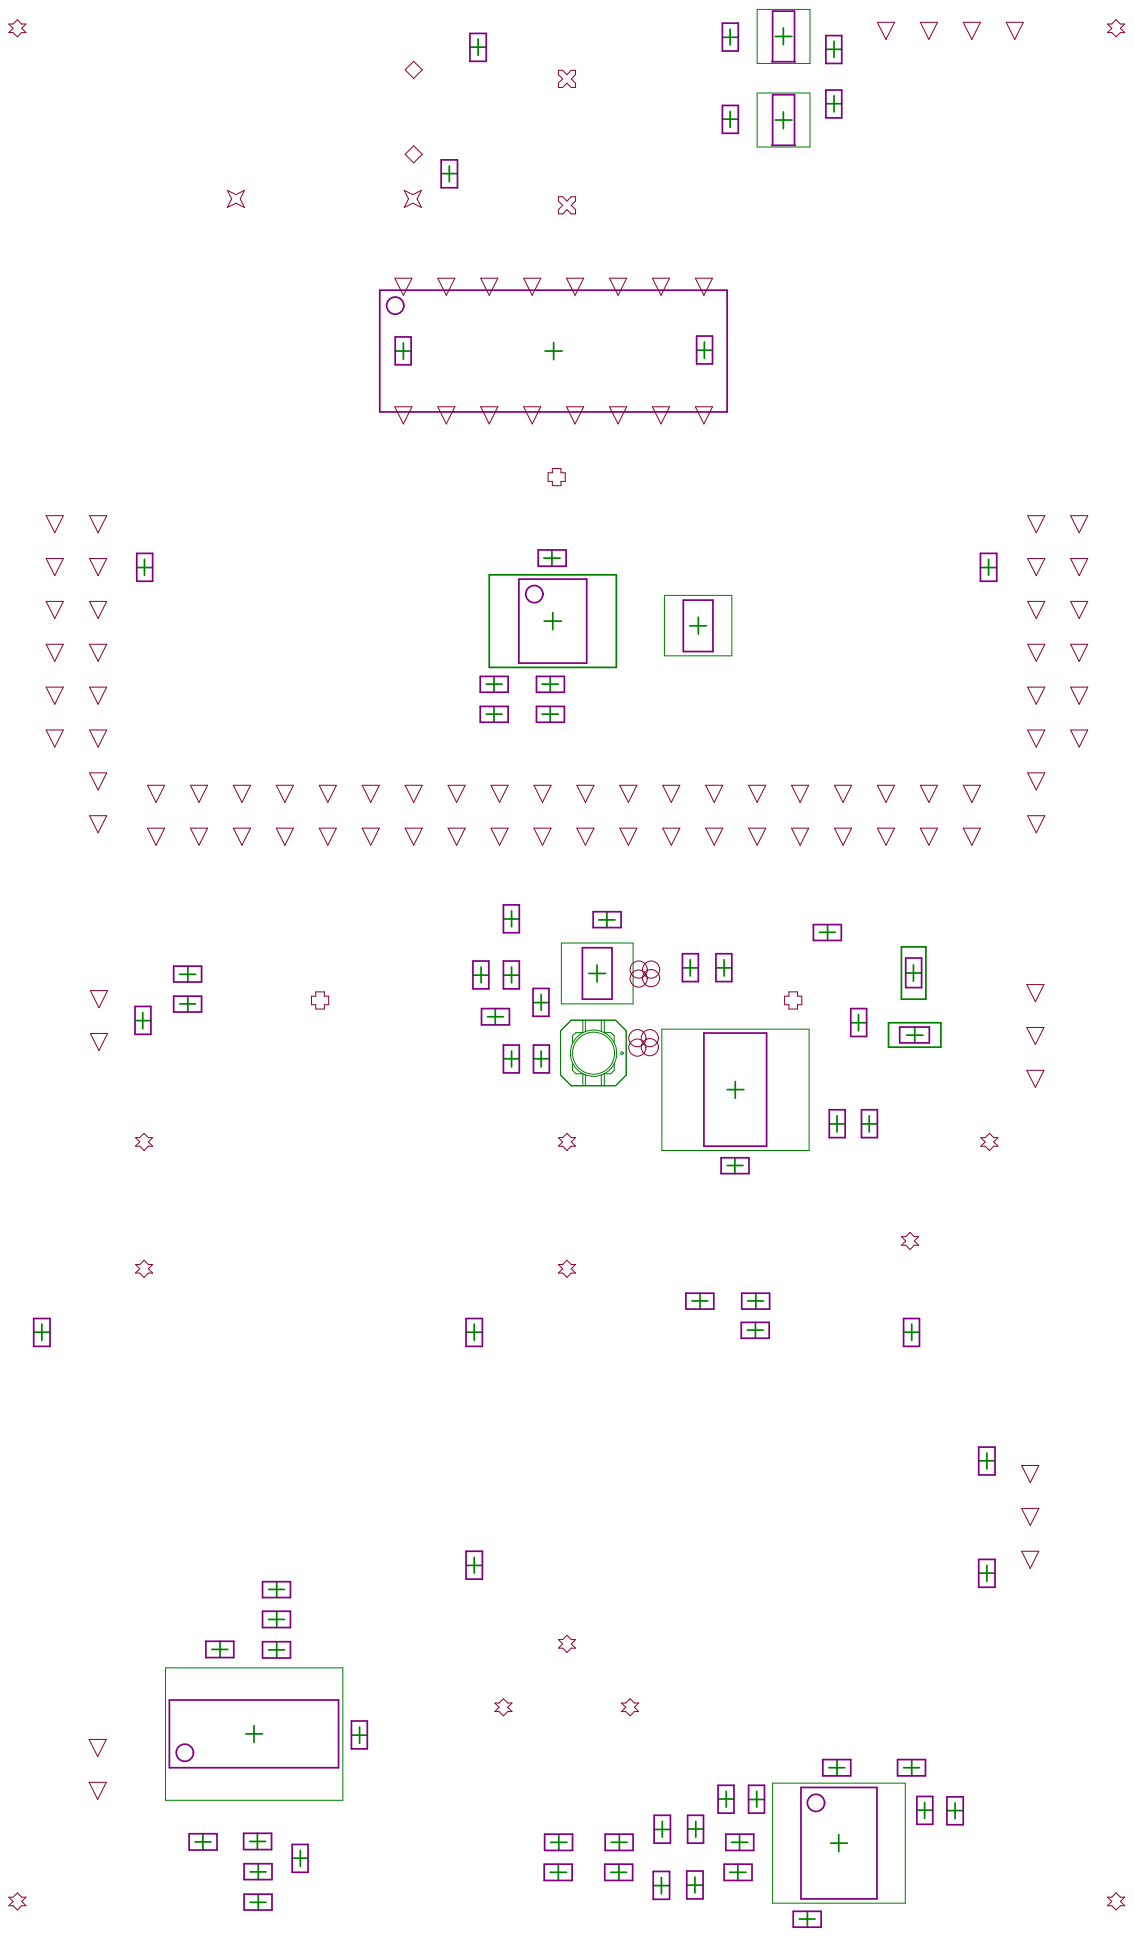
[picture p28: page 12]

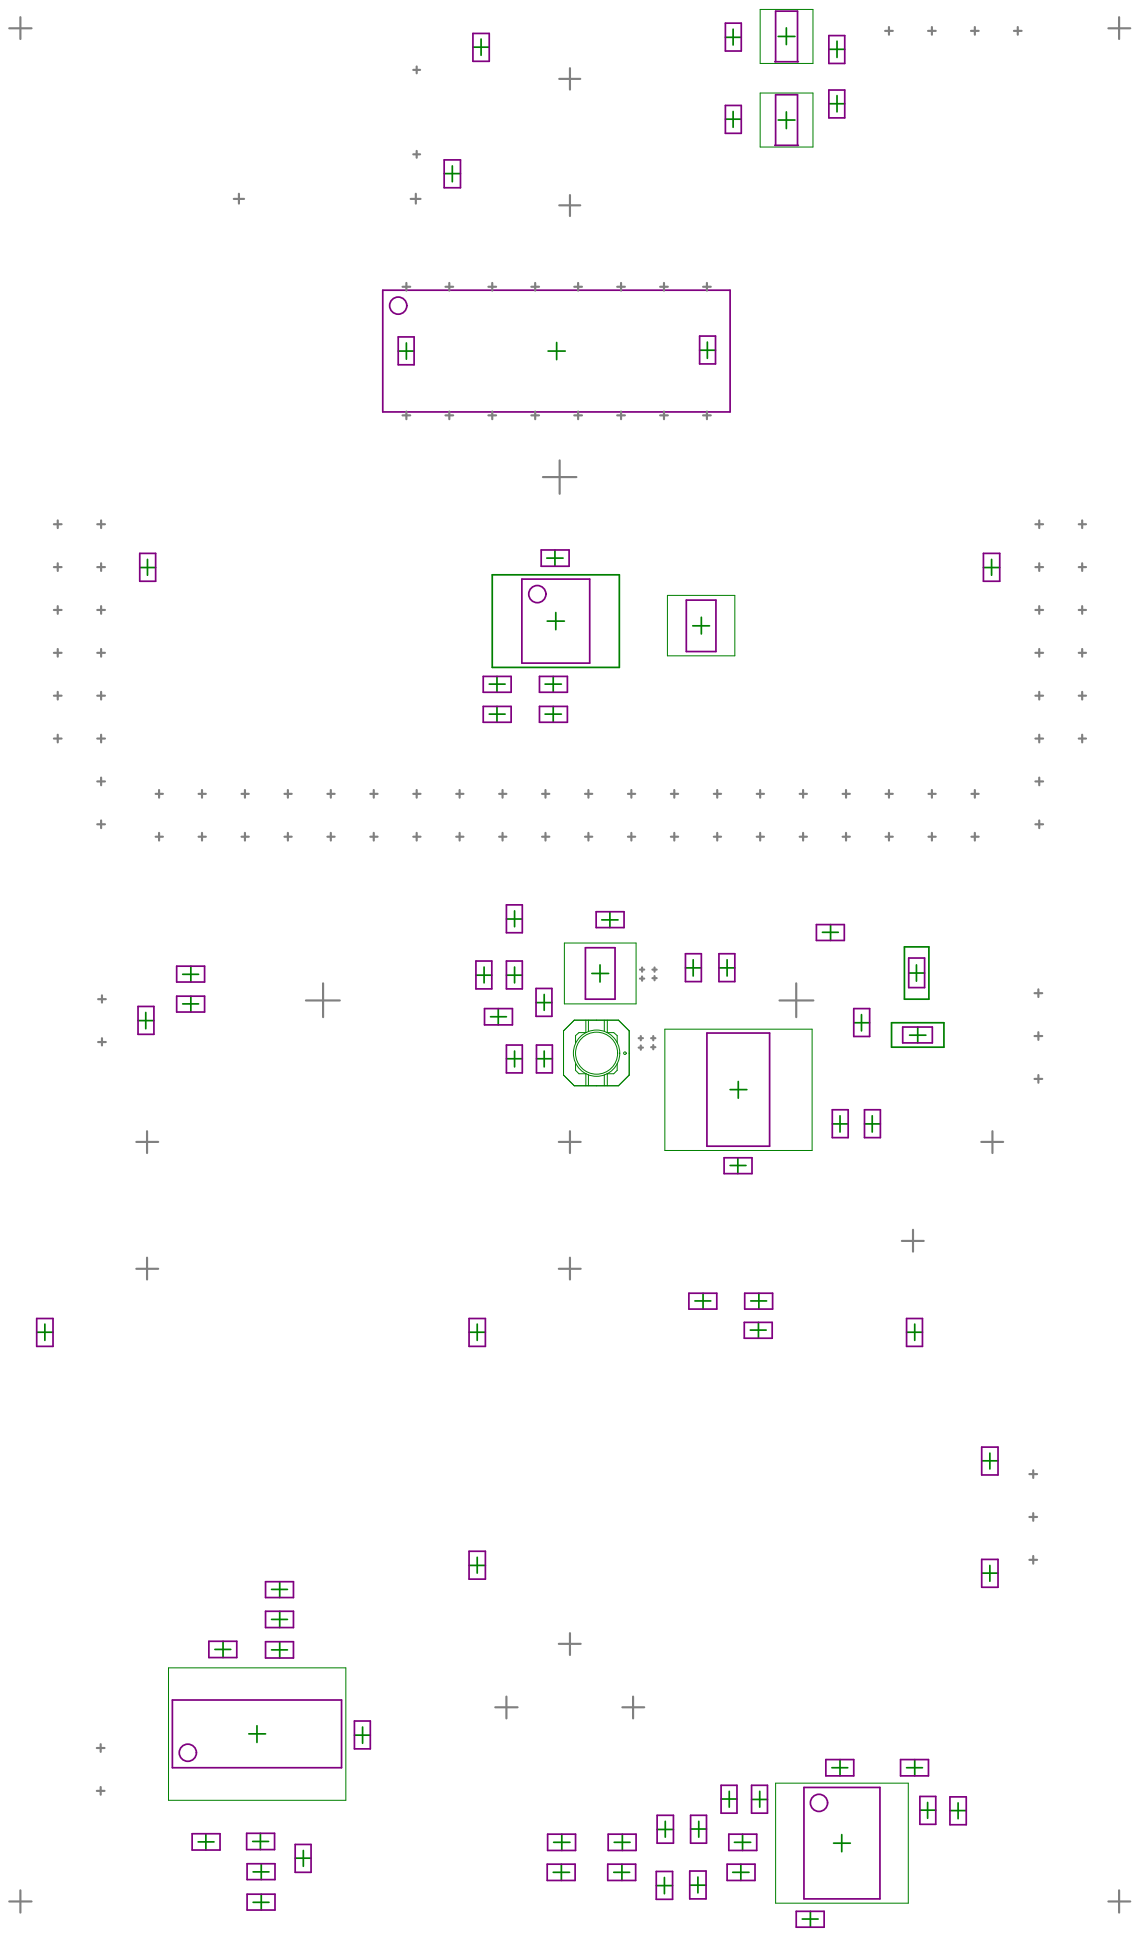
[picture p29: page 13]
