nabaztag2018/hardware/(list of files, drawings)

Other design files:
tagtagtag_V2.0/Altium sources/BSS138.PcbLib
tagtagtag_V2.0/Altium sources/BSS138.SchLib
tagtagtag_V2.0/Altium sources/CMM3729_memsMIC.PcbLib
tagtagtag_V2.0/Altium sources/CMM3729_memsMIC.SchLib
tagtagtag_V2.0/Altium sources/Enero_HEADERS.PcbLib
tagtagtag_V2.0/Altium sources/Enero_HEADERS.SchLib
tagtagtag_V2.0/Altium sources/MAX9759.PcbLib
tagtagtag_V2.0/Altium sources/MAX9759.SchLib
tagtagtag_V2.0/Altium sources/Nabaztag_RPI_V2.0.PrjPcb
tagtagtag_V2.0/Altium sources/Neopixel.PcbLib
tagtagtag_V2.0/Altium sources/Neopixel.SchLib
tagtagtag_V2.0/Altium sources/PassiveSMT.PcbLib
tagtagtag_V2.0/Altium sources/PassiveSMT.schlib
tagtagtag_V2.0/Altium sources/PyNab_Audio.SchDoc
tagtagtag_V2.0/Altium sources/PyNab_Header_LED_RFID.SchDoc
tagtagtag_V2.0/Altium sources/PyNab_Motor&Encoders.SchDoc
tagtagtag_V2.0/Altium sources/PyNab_Power.SchDoc
tagtagtag_V2.0/Altium sources/RPI_B+_40Pin_Header.PcbLib
tagtagtag_V2.0/Altium sources/RPI_B+_40Pin_Header.SchLib
tagtagtag_V2.0/Altium sources/Si7021-A20.PcbLib
tagtagtag_V2.0/Altium sources/Si7021-A20.SchLib
tagtagtag_V2.0/Altium sources/SN74LVC2G17DBVR.PcbLib
tagtagtag_V2.0/Altium sources/SN74LVC2G17DBVR.SchLib
tagtagtag_V2.0/Altium sources/TPS54202H.PcbLib
tagtagtag_V2.0/Altium sources/TPS54202H.SchLib
tagtagtag_V2.0/Altium sources/WM8960.PcbLib
tagtagtag_V2.0/Altium sources/WM8960.SchLib
