nabaztag2018/hardware/(commit log)

2019-01-23 New PCB (v2)
    Added : audio amp + RFID connection + mechanical compatibility with tag:tag
2019-10-07 tagtagtag_V2
    Files for manufacturing
    [Assembly Testpoint Report for Nabaztag_RPI_V2.0.csv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]
2019-11-26 Altium export
    Hope that helps !
    [BSS138.PcbLib, BSS138.SchLib, CMM3729_memsMIC.PcbLib, CMM3729_memsMIC.SchLib, Enero_HEADERS.PcbLib, Enero_HEADERS.SchLib, MAX9759.PcbLib, MAX9759.SchLib]
2022-07-05 Added NFC and put old files in legacy directory
    [BOM_Nabaztag_Revision_V4.1.xlsx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]
